diego123cruz/Z80Mini/README.md

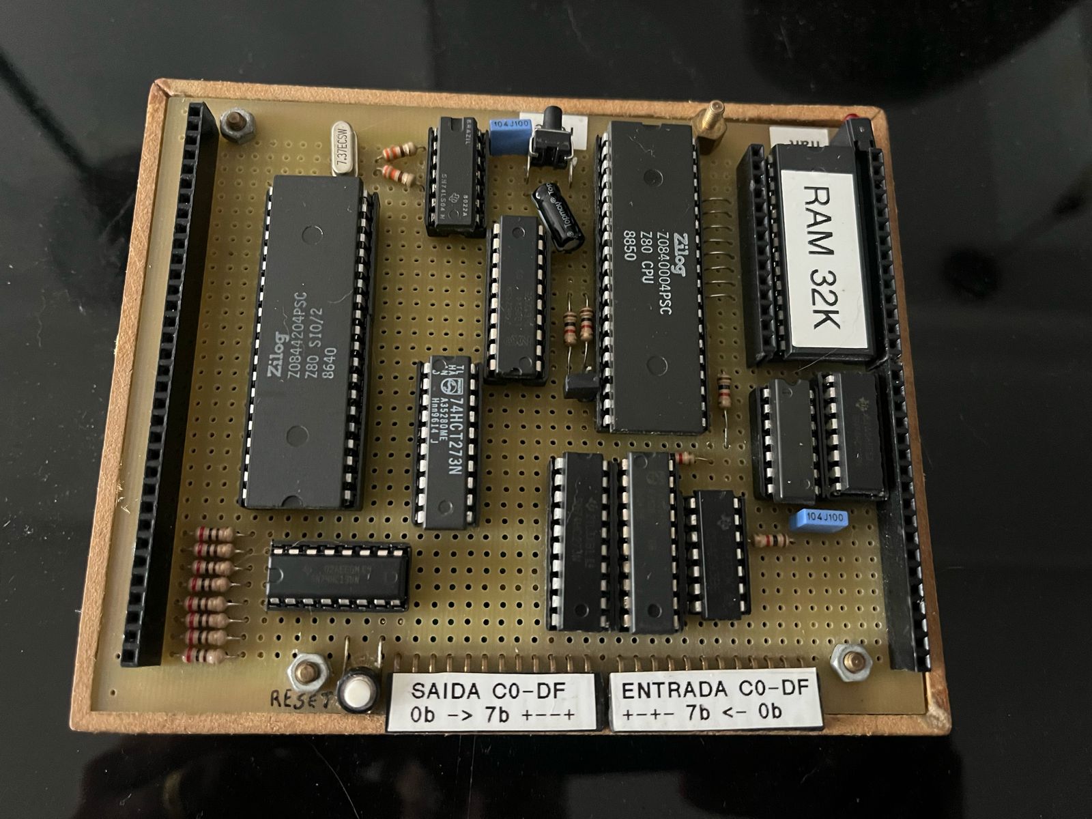
[picture p1: Z80Mini_BaseBoard.jpeg]
Z80Mini BaseBoard


# Z80Mini
Z80Mini foi pensado para ser um computador portátil e modular, temos uma placa base com o processador Z80 rodando em 7.372800Mhz, 32Kb de memória RAM, um soquete para a memória ROM, (que pode ser instalada na placa "Face"), duas portas de entradas e duas de saídas (a porta de saída 40h está ligada no barramento através de resistores de 200R).

## Spec
Z80 @7.372800Mhz

RAM 32kb @62256

ROM 32Kb @28C256

## Serial - SIO/2
SIOA_D $00 - MainBoard USB-Serial 115200 (FTDI)

SIOA_C $02 - MainBoard USB-Serial 115200 (FTDI)

SIOB_D $01 - Não usado

SIOB_C $03 - Não usado

## IN / OUT
OUT_40h with resistor 200R

IN_40h

OUT_C0h

IN_C0h

## Z80Mini - BaseBoard
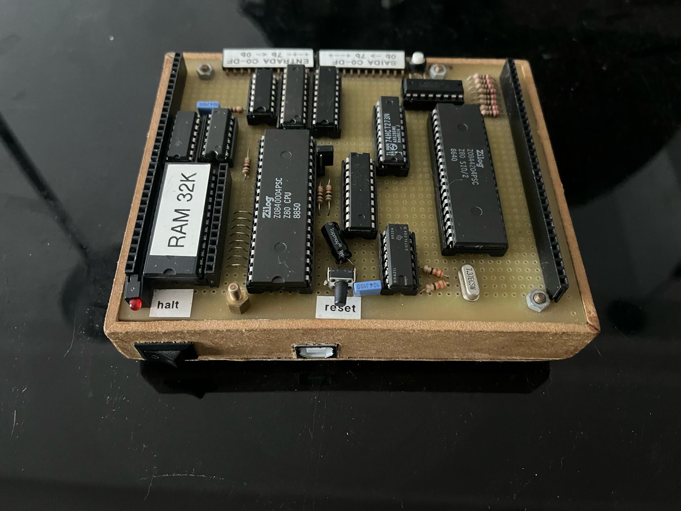
[picture p2: Z80Mini_BaseBoardPower.jpeg]
Z80Mini


[Schematic - All boards](https://github.com/diego123cruz/Z80Mini/blob/main/Schematic/Z80%20Mini%20-%20All%20boards.PDF)

## Faces
### Z80 Mem­ber­ship Card - Face
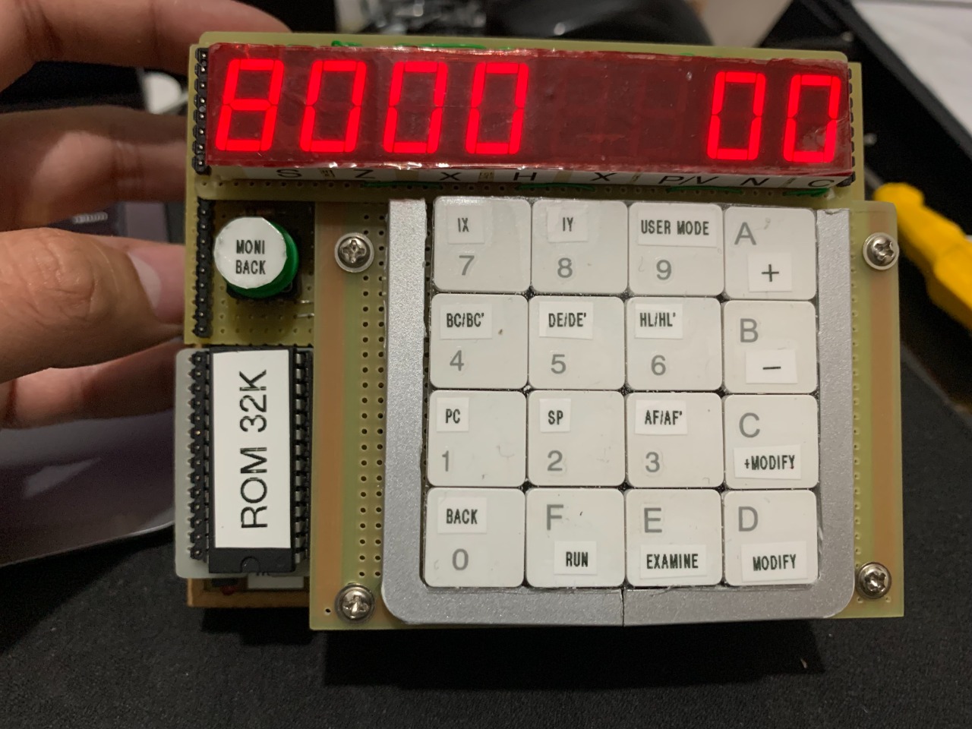
[picture p3: Z80 Mem­ber­ship Card - Face/Z80 Membership Card.jpeg]


[Vídeo](https://www.youtube.com/watch?v=1eWTQVRYLUw)

Essa placa "Face" foi baseada no "The Z80 Mem­ber­ship Card" - http://www.sunrise-ev.com/z80.htm

O circuito ou código-fonte podem conter partes do projeto original mencionado acima. Para mais detalhes sobre licenças copyright  consulte o autor do projeto original (http://www.sunrise-ev.com/z80.htm)

### Tec 1F (Southen Cross) - Face
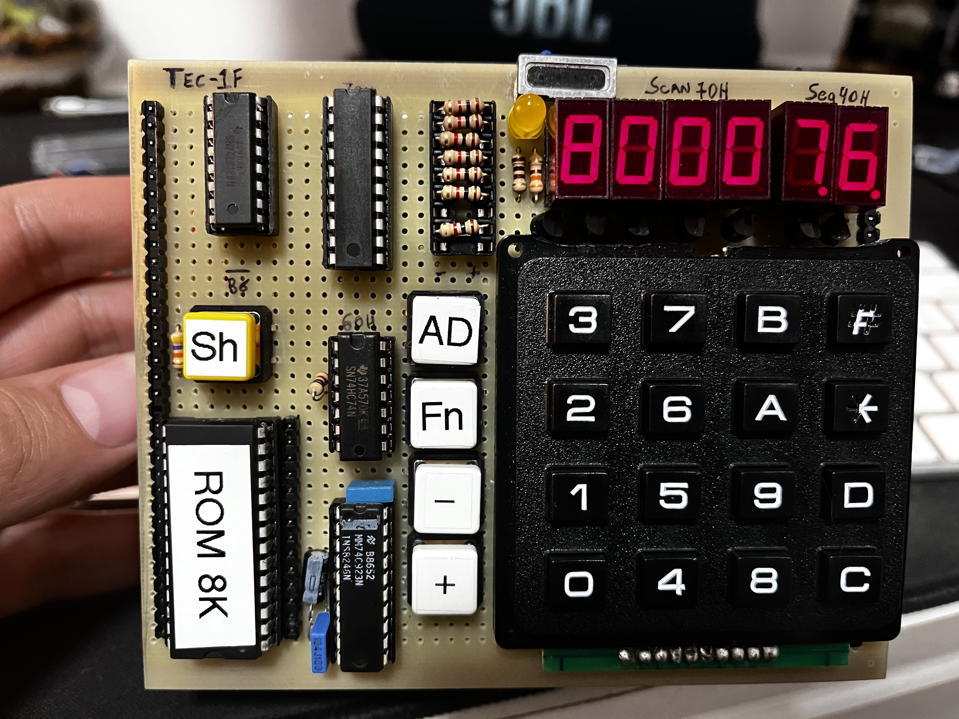
[picture p4: TEC-1(SC) - Face/Z80Mini-SouthernCross.jpeg]
Z80Mini


[Vídeo](https://www.youtube.com/watch?v=lcZihEMK4z4)

Essa placa "Face" foi baseada no "TEC 1 - Talking Electronics" (https://www.talkingelectronics.com/te_interactive_index.html) e tambem em algumas montagens:

Southern Cross Computer - https://github.com/crsjones/Southern-Cross-Computer-z80

The Big (Brian's) Monitor for the TEC-1F - https://github.com/bchiha/BMon

O circuito ou código-fonte podem conter partes dos projetos originais mencionado acima. Para mais detalhes sobre licenças copyright consulte os autores dos projetos originais.

### Basic LCD V1 - Face [DESCONTINUADO]
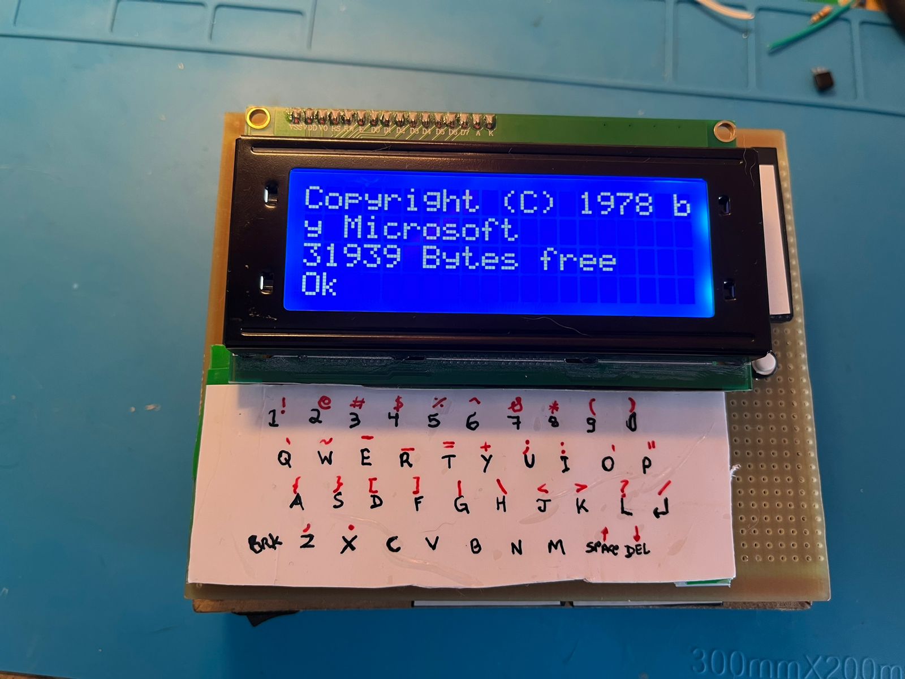
[picture p5: Basic LCD - Face [Descontinuado]/BasicLCD V1-Face.jpeg]


[Vídeo demo](https://www.youtube.com/watch?v=0nLOt6mwVDU)

[Vídeo detalhes](https://www.youtube.com/watch?v=qB5lAR5NyGU)

### Basic LCD Graphic 128x64 V2 - Face [DESCONTINUADO]
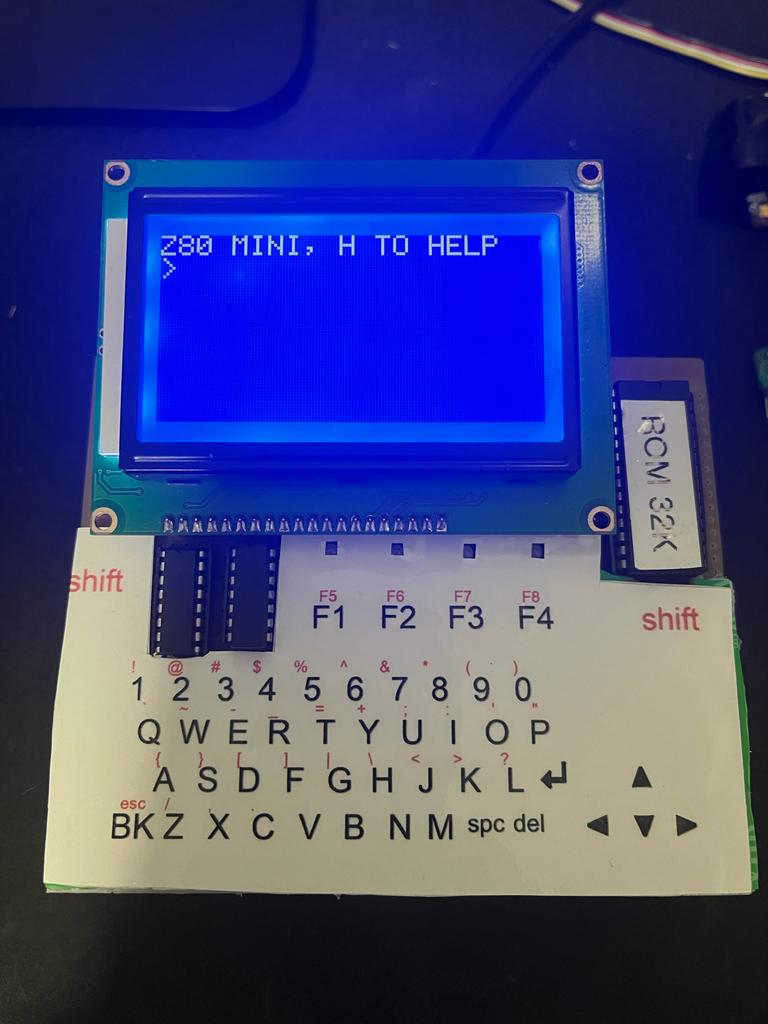
[picture p6: Basic LCD - Face [Descontinuado]/Basic LCD V2 (Graphic 128x64) - Face.jpg]


### Basic LCD Graphic 128x64 V3 - Face [NEW]
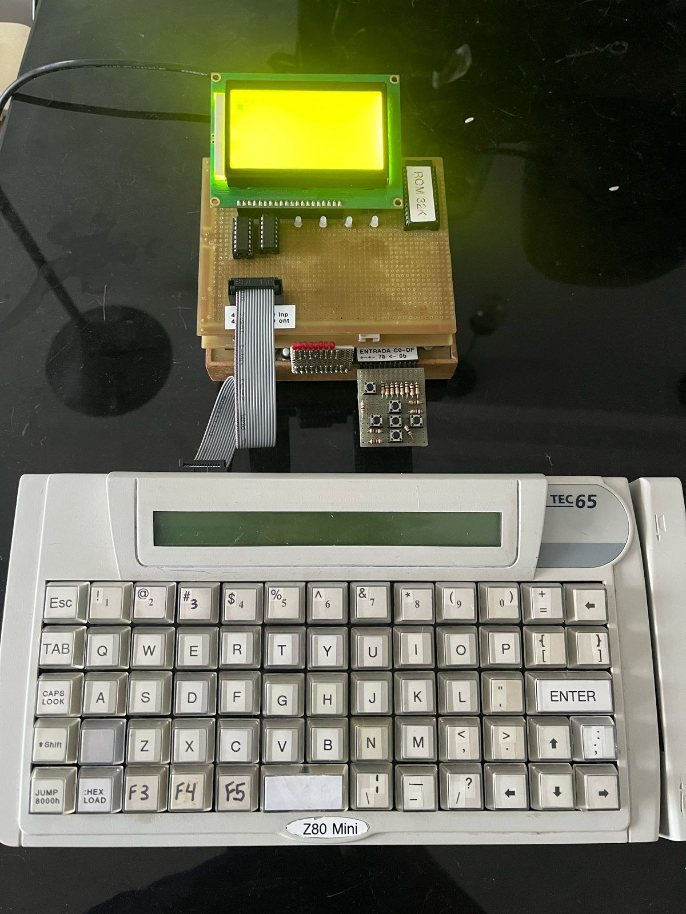
[picture p7: Z80MiniV3.jpeg]
Z80MiniV3


[Vídeo demo](https://www.youtube.com/shorts/OemEQMpTLIQ)

### GameCore - Face [NEW]
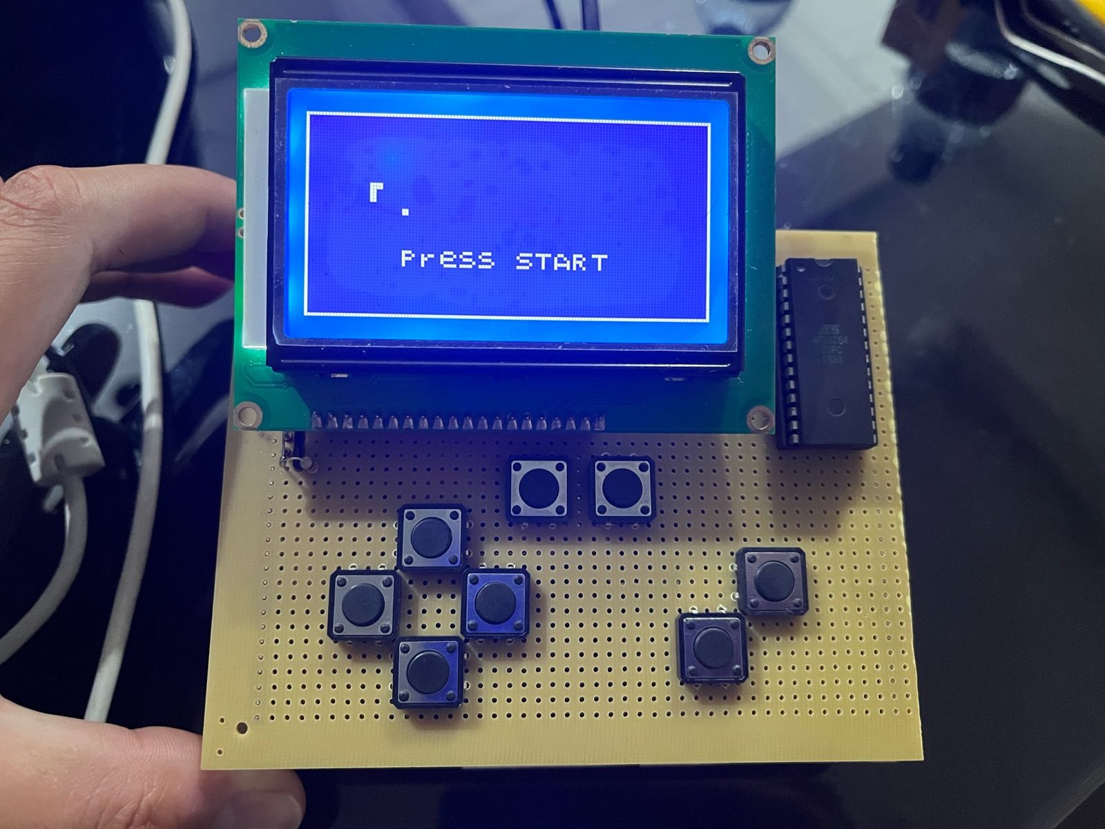
[picture p8: Z80Mini_GameCore_Face.jpeg]
Z80MiniGameCore


Essa placa "Face" foi baseada no "Grant's 7-chip Z80 computer" - http://searle.walesz80.htm e "Z80 SINGLE BOARD COMPUTER" - http://d-fence.sytes.net/z80sbc/

O circuito ou código-fonte podem conter partes do projeto original mencionado acima. Para mais detalhes sobre licenças copyright consulte os autores dos projetos originais.

### Mais vídeos
[Meu canal](https://www.youtube.com/@diego123cruz/videos)
