diego123cruz/Z80Mini/Graphics Display + Keyboard 65 - Face/README.md

Z80Mini Graphics LCD v3 Z80Mini BaseBoard

### Graphics Display (128x64) + Keyboard TEC 65 - Face

Essa placa "Face" foi baseada no "Grant's 7-chip Z80 computer" - http://searle.walesz80.htm e "Z80 SINGLE BOARD COMPUTER" - http://d-fence.sytes.net/z80sbc/

O circuito ou código-fonte podem conter partes do projeto original mencionado acima. Para mais detalhes sobre licenças copyright consulte os autores dos projetos originais.
