diego123cruz/Z80Mini/TEC-1(SC) - Face/ReferenceFiles/Docs/MemoryDevices01.pdf

# 28 Pin EPROM, EEPROM and RAM Pinouts

### Note:

1. CE,OE,WE are Active low inputs.
2. In general NC pins should be left unconnected. Consult the manufacturer’s data for specific information.
3. VPP and PGM pins should be connected to VCC when not used in programming, except for the 2732 dual function pin 20, OE/VPP.
4. Connect the WE of EEPROM devices to VCC to inhibit unintentional write cycles.

Craig Jones 09/21 V1

SRAM | EEPROM | EPROM | SRAM | EEPROM | EPROM | EPROM | SRAM | EEPROM | EPROM | EPROM | EEPROM | SRAM | EPROM | EPROM | EEPROM | SRAM | EPROM | EEPROM | SRAM
62256 | 28C256 | 27256 | 6264 | 28C64 | 2764 | 2732 | 6116 | 28C16 | 2716 | 2716 | 28C16 | 6116 | 2732 | 2764 | 28C64 | 6264 | 27256 | 28C256 | 62256
A14 | A14 | VPP | NC | NC | VPP | | | | | | | | | VCC | VCC | VCC | VCC | VCC | VCC
A12 | A12 | A12 | A12 | A12 | A12 | | | | | | | | | PGM | WE | WE | A14 | WE | WE
A7 | A7 | A7 | A7 | A7 | A7 | A7 | A7 | A7 | A7 | VCC | VCC | VCC | VCC | NC | NC | CS2 | A13 | A13 | A13
A6 | A6 | A6 | A6 | A6 | A6 | A6 | A6 | A6 | A6 | A8 | A8 | A8 | A8 | A8 | A8 | A8 | A8 | A8 | A8
A5 | A5 | A5 | A5 | A5 | A5 | A5 | A5 | A5 | A5 | A9 | A9 | A9 | A9 | A9 | A9 | A9 | A9 | A9 | A9
A4 | A4 | A4 | A4 | A4 | A4 | A4 | A4 | A4 | A4 | VPP | WE | WE | A11 | A11 | A11 | A11 | A11 | A11 | A11
A3 | A3 | A3 | A3 | A3 | A3 | A3 | A3 | A3 | A3 | OE | OE | OE | OE/VPP | OE | OE | OE | OE | OE | OE
A2 | A2 | A2 | A2 | A2 | A2 | A2 | A2 | A2 | A2 | A10 | A10 | A10 | A10 | A10 | A10 | A10 | A10 | A10 | A10
A1 | A1 | A1 | A1 | A1 | A1 | A1 | A1 | A1 | A1 | CE | CE | CE | CE | CE | CE | CE | CE | CE | CE
A0 | A0 | A0 | A0 | A0 | A0 | A0 | A0 | A0 | A0 | D7 | D7 | D7 | D7 | D7 | D7 | D7 | D7 | D7 | D7
D0 | D0 | D0 | D0 | D0 | D0 | D0 | D0 | D0 | D0 | D6 | D6 | D6 | D6 | D6 | D6 | D6 | D6 | D6 | D6
D1 | D1 | D1 | D1 | D1 | D1 | D1 | D1 | D1 | D1 | D5 | D5 | D5 | D5 | D5 | D5 | D5 | D5 | D5 | D5
D2 | D2 | D2 | D2 | D2 | D2 | D2 | D2 | D2 | D2 | D4 | D4 | D4 | D4 | D4 | D4 | D4 | D4 | D4 | D4
GND | GND | GND | GND | GND | GND | GND | GND | GND | GND | D3 | D3 | D3 | D3 | D3 | D3 | D3 | D3 | D3 | D3
