diego123cruz/Z80Mini/Z80 Membership Card  - Face/README.md

Z80 Mem­ber­ship Card - Face

### Z80 Mem­ber­ship Card - Face
Essa placa "Face" foi baseada no "The Z80 Mem­ber­ship Card" - http://www.sunrise-ev.com/z80.htm

O circuito ou código-fonte podem conter partes do projeto original mencionado acima. Para mais detalhes sobre licenças copyright  consulte o autor do projeto original (http://www.sunrise-ev.com/z80.htm)

[Vídeo](https://www.youtube.com/watch?v=1eWTQVRYLUw)

#### Base board

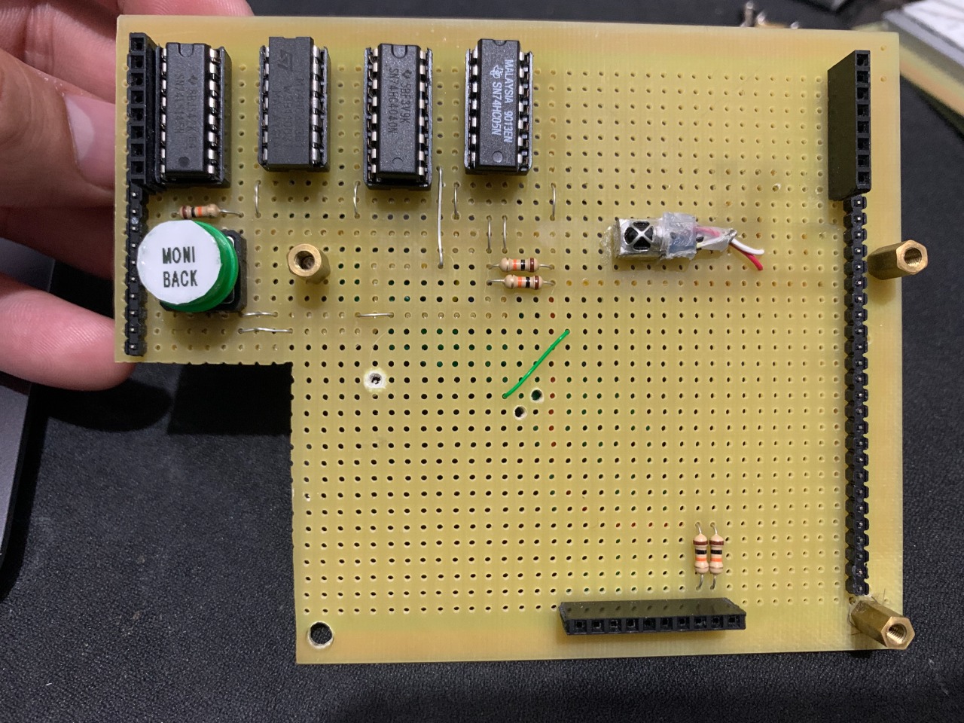
[picture p9: Z80 Membership Card - Face/Base.jpeg]
Base


#### Keyboard

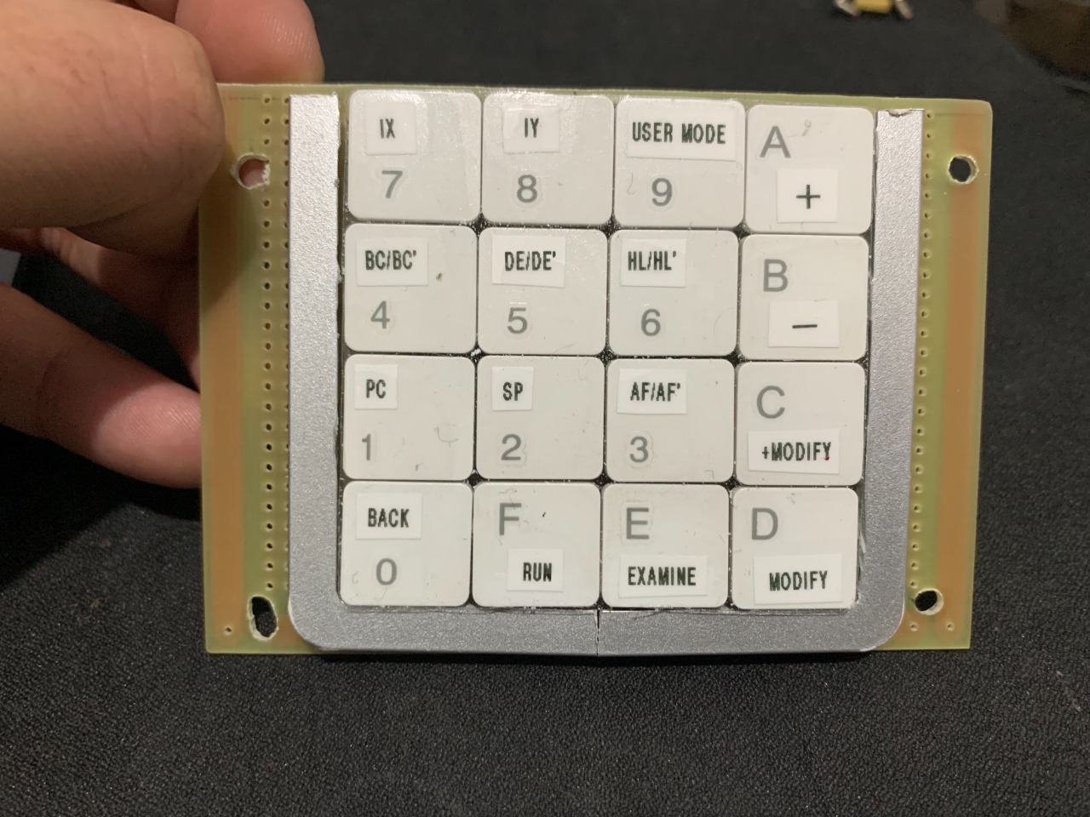
[picture p10: Z80 Membership Card - Face/Keyboard.jpeg]
keys


#### 7Seg display

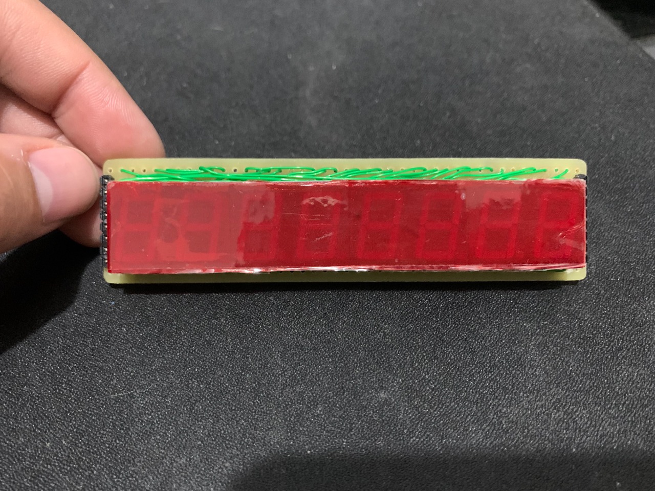
[picture p11: Z80 Membership Card - Face/7SegDisplay.jpeg]
7Segs display
