diego123cruz/Z80Mini/Basic LCD - Face [Descontinuado]/README.md

Z80Mini LCD v1 Z80Mini BaseBoard

### Basic LCD V1 - Face

[Vídeo demo](https://www.youtube.com/watch?v=0nLOt6mwVDU)

[Vídeo detalhes](https://www.youtube.com/watch?v=qB5lAR5NyGU)

Z80Mini BaseBoard Z80Mini LCD v2 128x64

### Basic LCD V2 (Graphic 128x64) - Face

Essa placa "Face" foi baseada no "Grant's 7-chip Z80 computer" - http://searle.walesz80.htm e "Z80 SINGLE BOARD COMPUTER" - http://d-fence.sytes.net/z80sbc/

O circuito ou código-fonte podem conter partes do projeto original mencionado acima. Para mais detalhes sobre licenças copyright consulte os autores dos projetos originais.

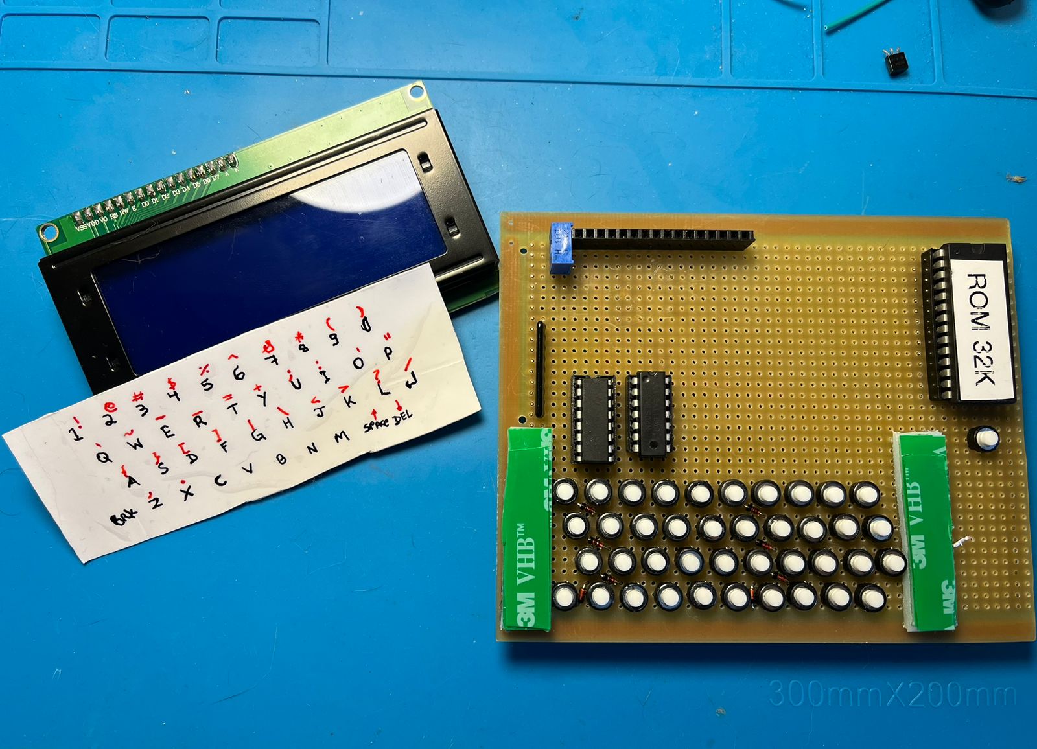
[picture p12: Basic LCD - Face [Descontinuado]/BasicLCDParts-Face.jpeg]
Z80Mini
