diego123cruz/Z80Mini/BIOS/Programas/Display lcd 40x2 IIC/example.jpeg

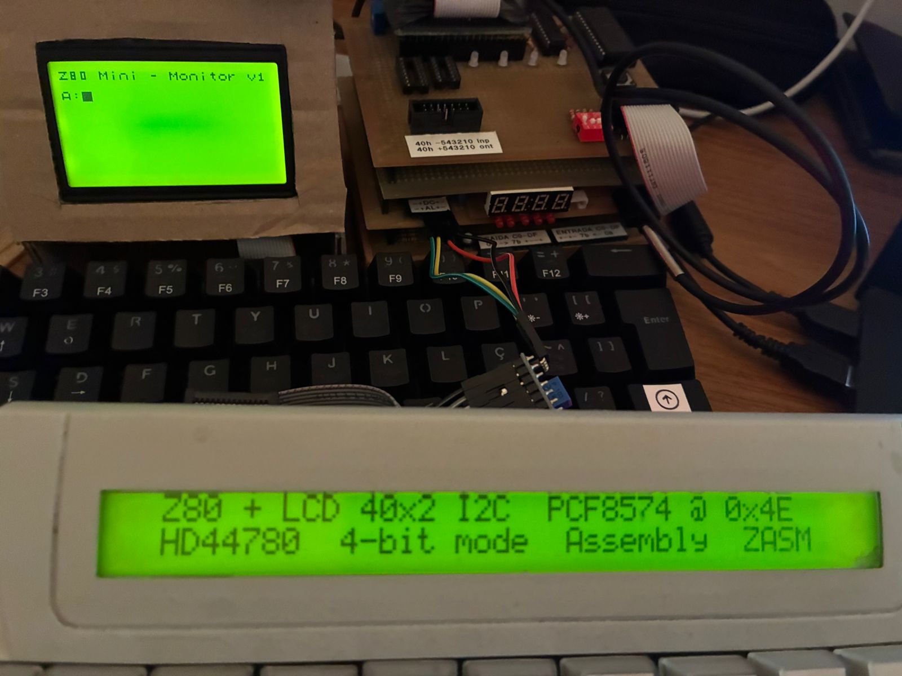
BIOS/Programas/Display lcd 40x2 IIC/example.jpeg
