diego123cruz/Z80Mini/BIOS/Programas/Display oled ssd1306_128x32/example.jpeg

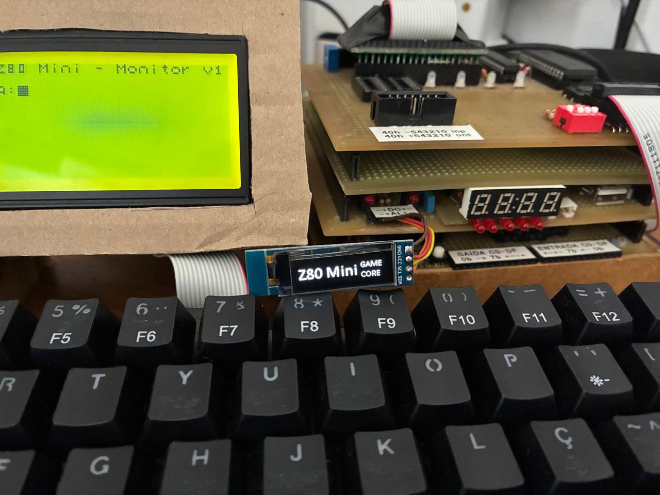
BIOS/Programas/Display oled ssd1306_128x32/example.jpeg
