diego123cruz/Z80Mini/BIOS/Programas/Display oled ssd1306_128x32/image/LLCDAssistant - example.JPG

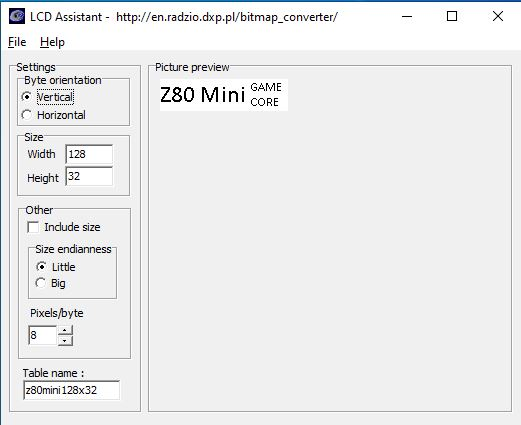
BIOS/Programas/Display oled ssd1306_128x32/image/LLCDAssistant - example.JPG
