diego123cruz/Z80Mini/BIOS/Programas/Games/AirplaneBomb/example.jpeg

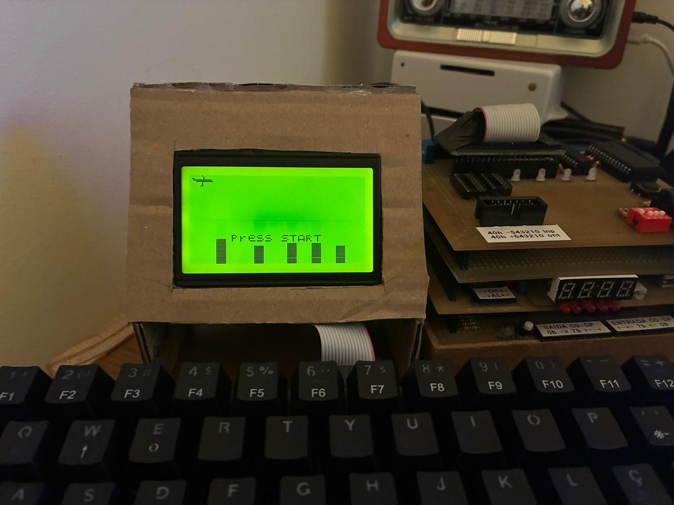
BIOS/Programas/Games/AirplaneBomb/example.jpeg
