diego123cruz/Z80Mini/BIOS/Programas/Games/Snake/example.jpeg

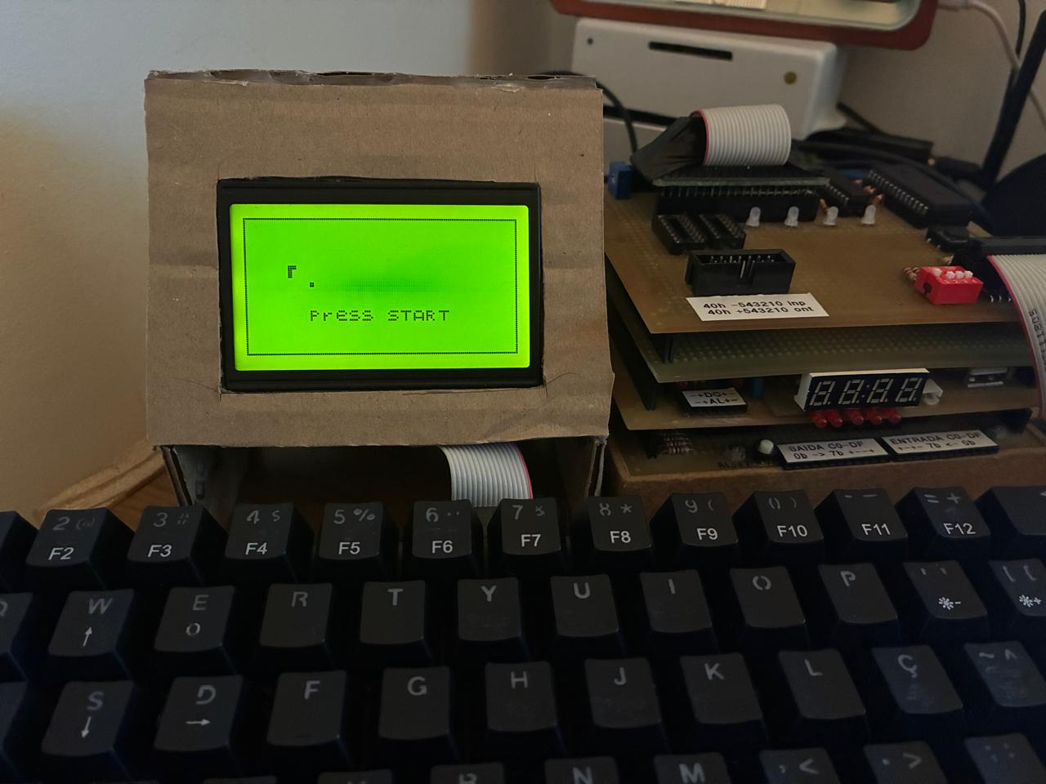
BIOS/Programas/Games/Snake/example.jpeg
