diego123cruz/Z80Mini/BIOS/Programas/Games/TankRun/example.jpeg

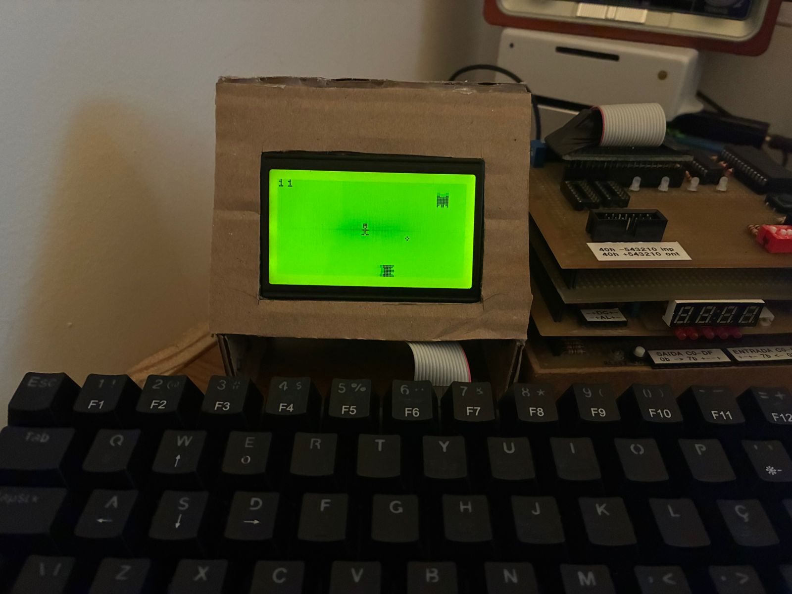
BIOS/Programas/Games/TankRun/example.jpeg
