diego123cruz/Z80Mini/BIOS/Programas/Games/TicTacToe/example.jpeg

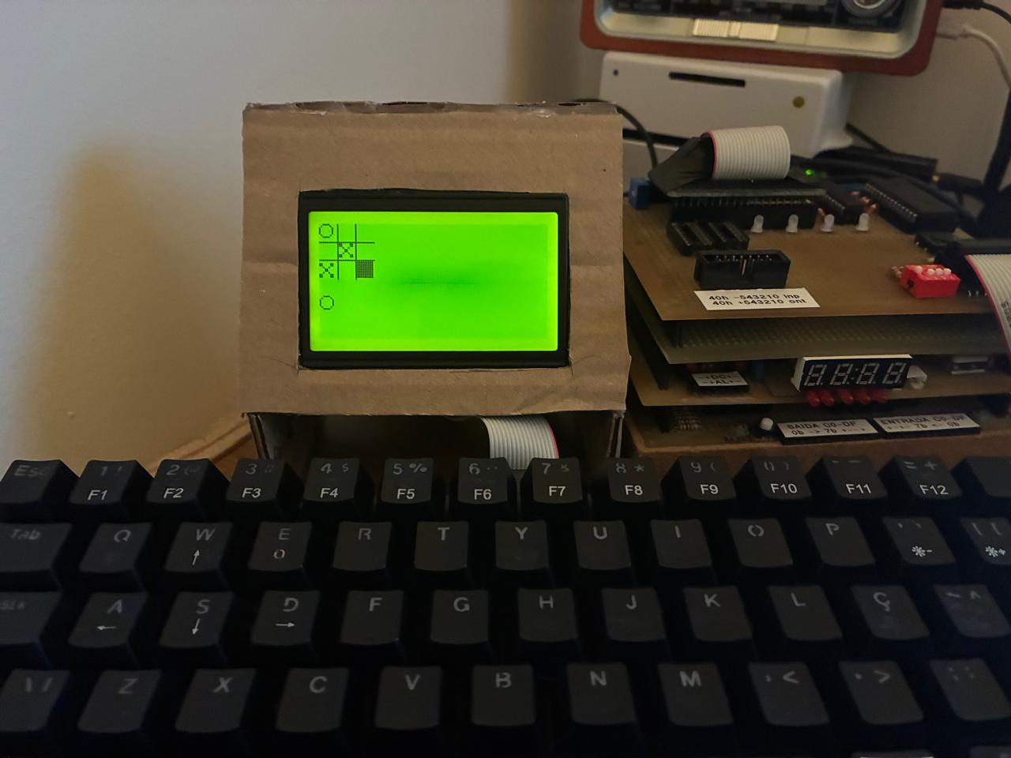
BIOS/Programas/Games/TicTacToe/example.jpeg
