diego123cruz/Z80Mini/BIOS/Programas/Relogio/example.jpeg

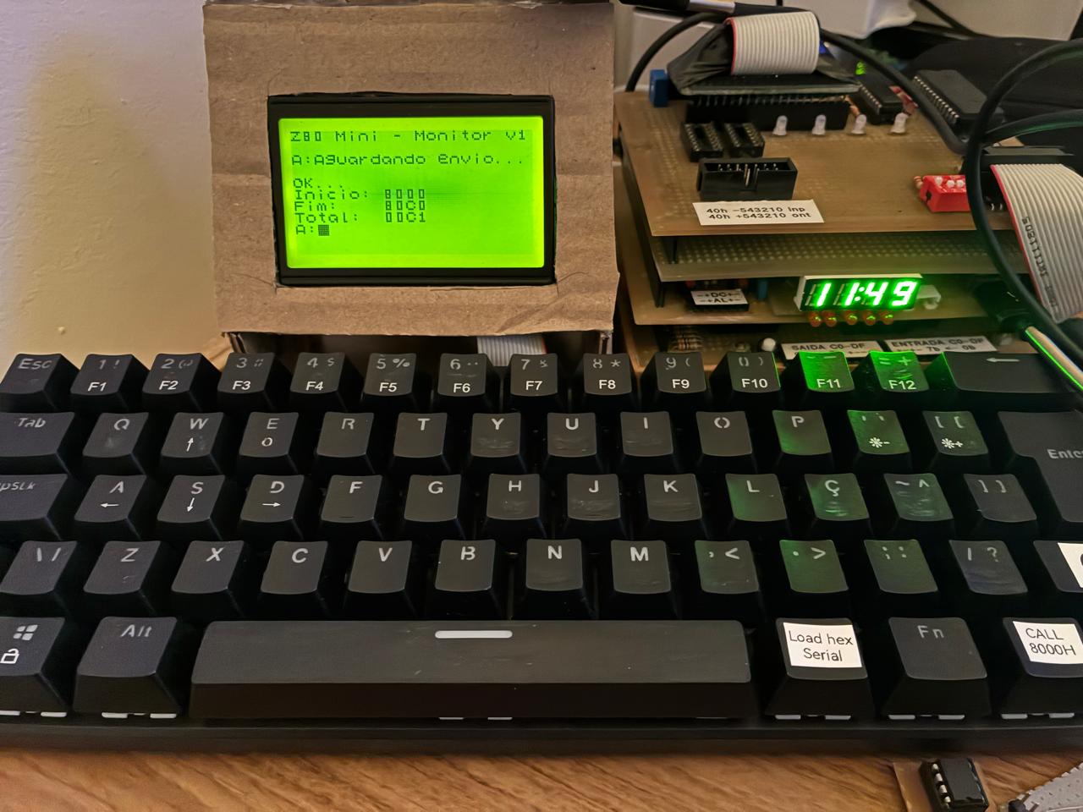
BIOS/Programas/Relogio/example.jpeg
