diego123cruz/Z80Mini/BIOS/Programas/SSD1306_SSD1106_I2C_128x64/SSD1306.jpeg

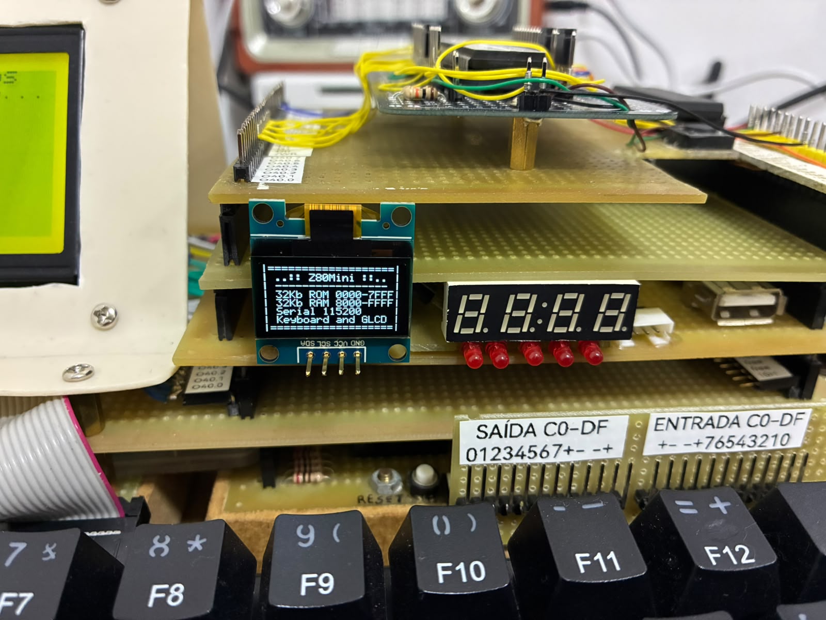
BIOS/Programas/SSD1306_SSD1106_I2C_128x64/SSD1306.jpeg
