diego123cruz/Z80Mini/BIOS/Programas/Term v0.1/example.jpeg

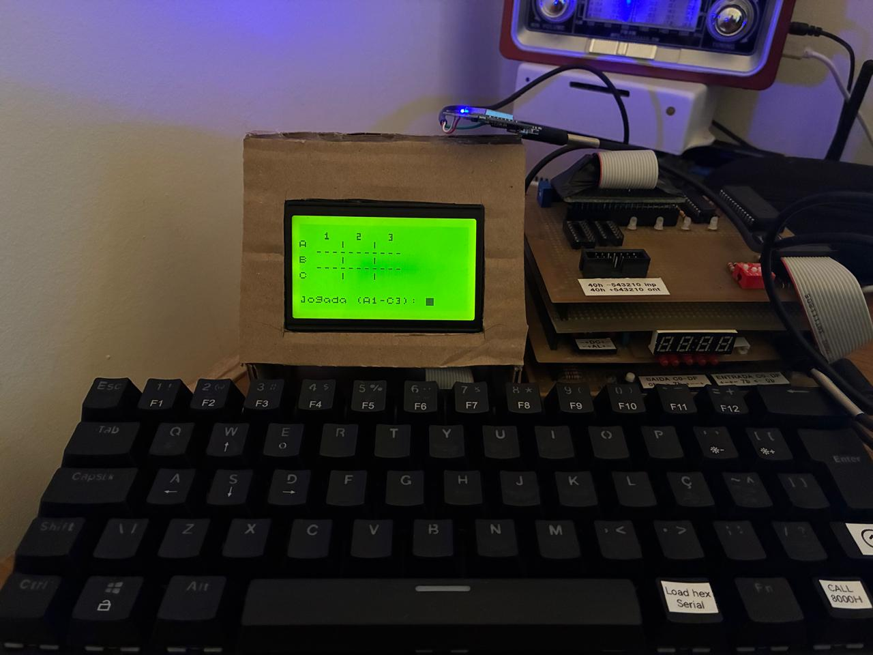
BIOS/Programas/Term v0.1/example.jpeg
