diego123cruz/Z80Mini/BIOS/sdcc /demo/example.jpeg

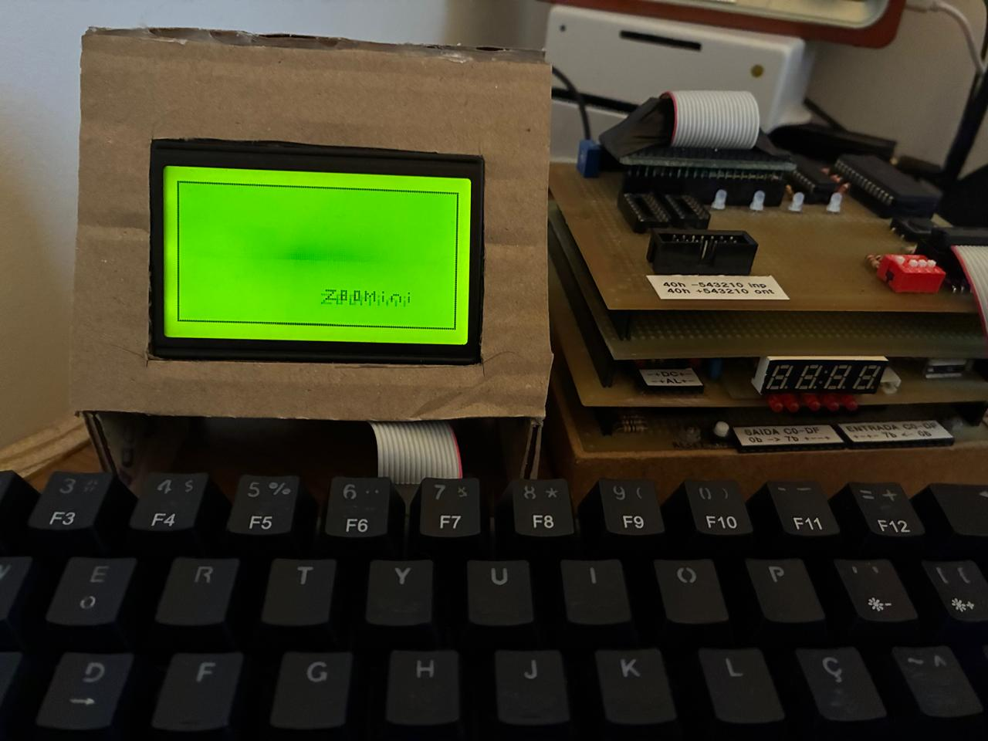
BIOS/sdcc /demo/example.jpeg
