diego123cruz/Z80Mini/BIOS/sdcc /filter/example.jpeg

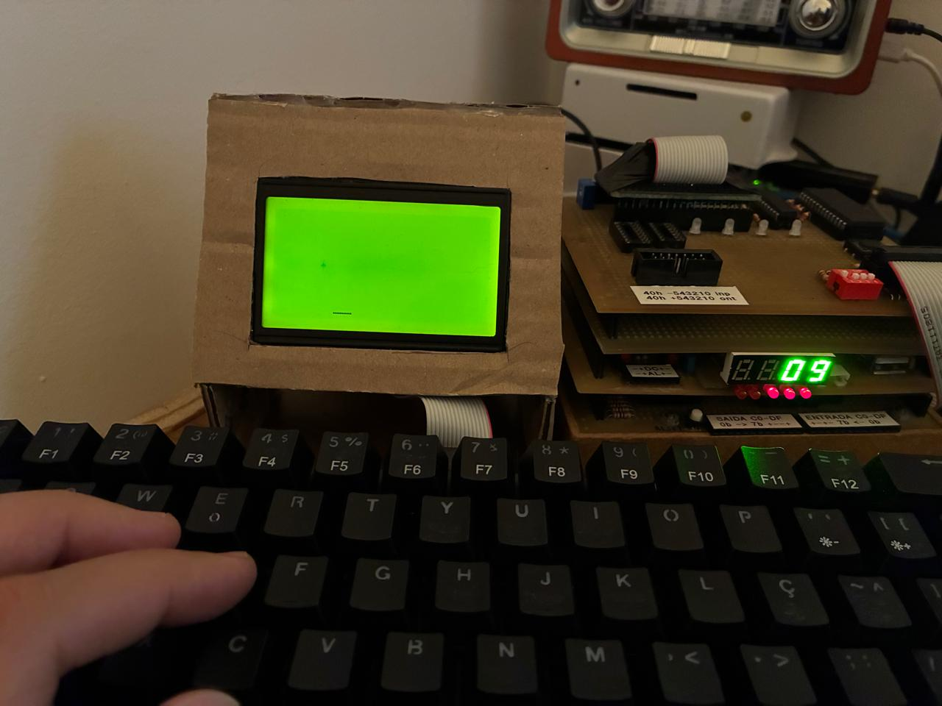
BIOS/sdcc /filter/example.jpeg
