diego123cruz/Z80Mini/External Feature/ArduBox_I2C/ArduBoxIIC.jpeg

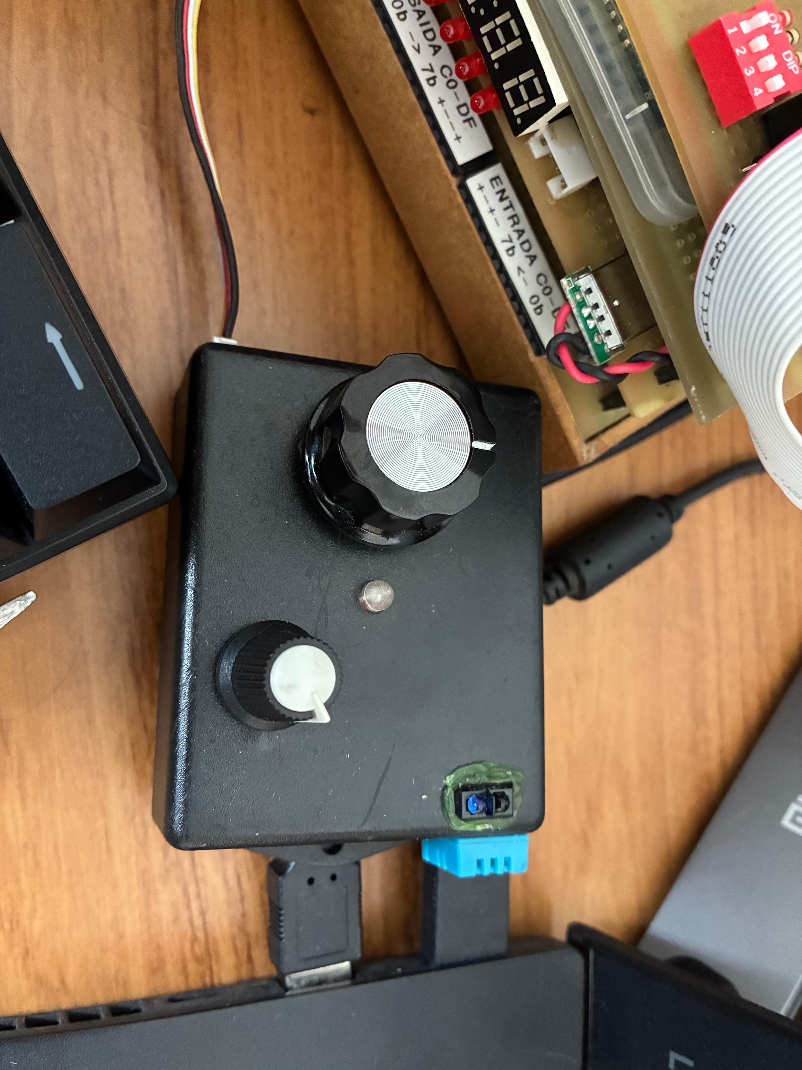
External Feature/ArduBox_I2C/ArduBoxIIC.jpeg
