diego123cruz/Z80Mini/External Feature/ArduBox_I2C/Circuit.jpeg

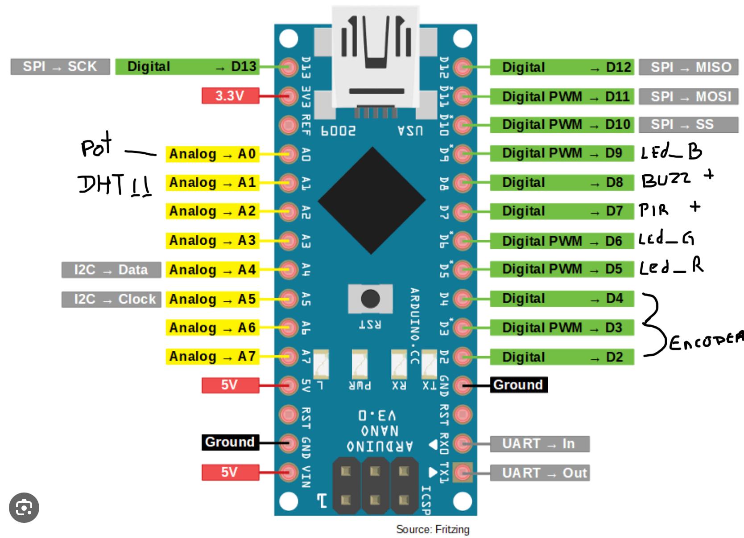
External Feature/ArduBox_I2C/Circuit.jpeg
