diego123cruz/Z80Mini/External Feature/ArduBox_I2C/Commands.jpeg

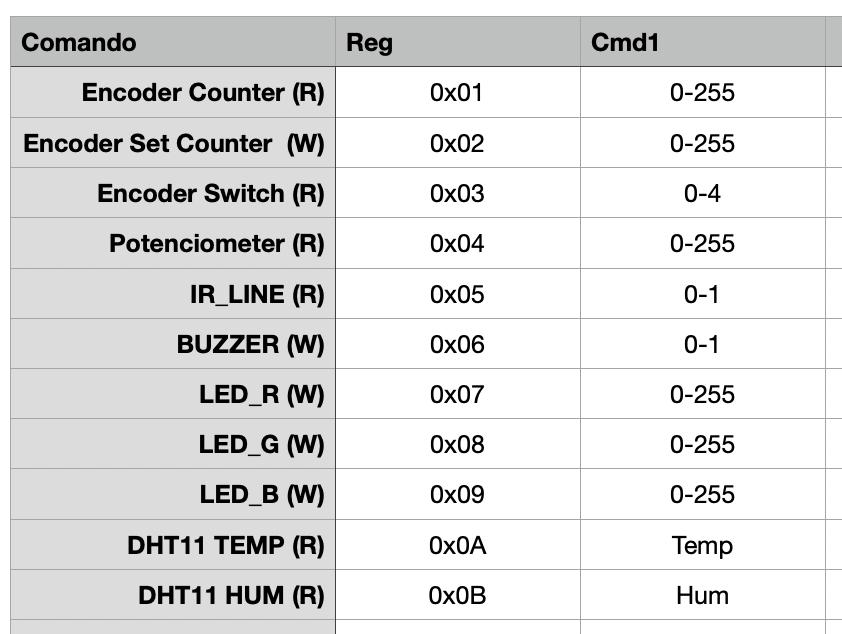
External Feature/ArduBox_I2C/Commands.jpeg
