diego123cruz/Z80Mini/External Feature/Display7segSom/ArduinoBoard.jpg

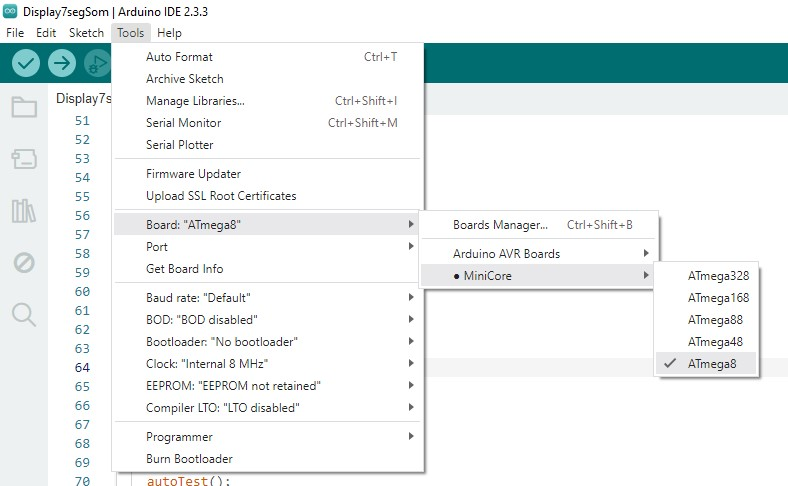
External Feature/Display7segSom/ArduinoBoard.jpg
