diego123cruz/Z80Mini/External Feature/Display7segSom/Atmega8_OscInt8Mhz.JPG

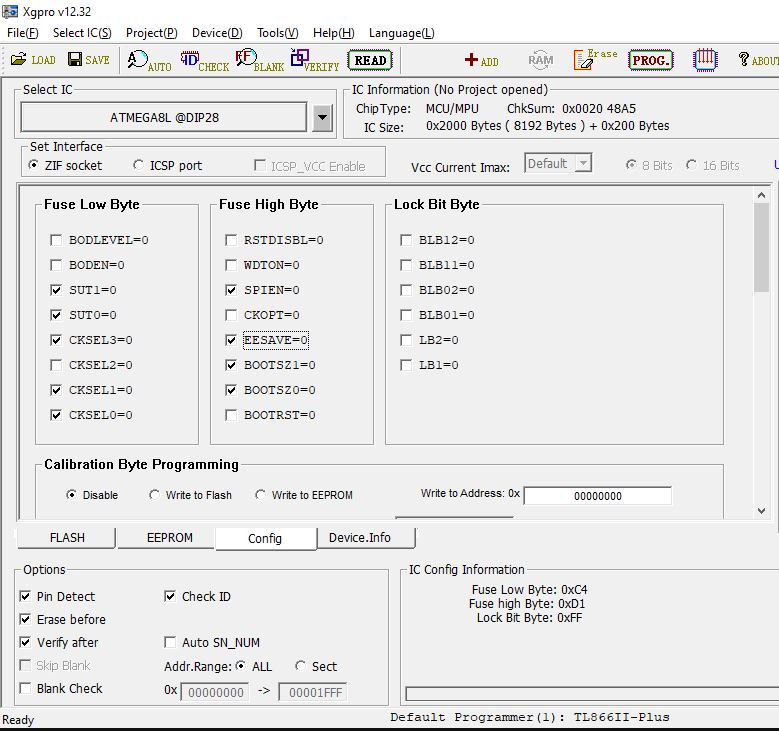
External Feature/Display7segSom/Atmega8_OscInt8Mhz.JPG
