diego123cruz/Z80Mini/External Feature/Display7segSom/atmega8_pinout.jpg

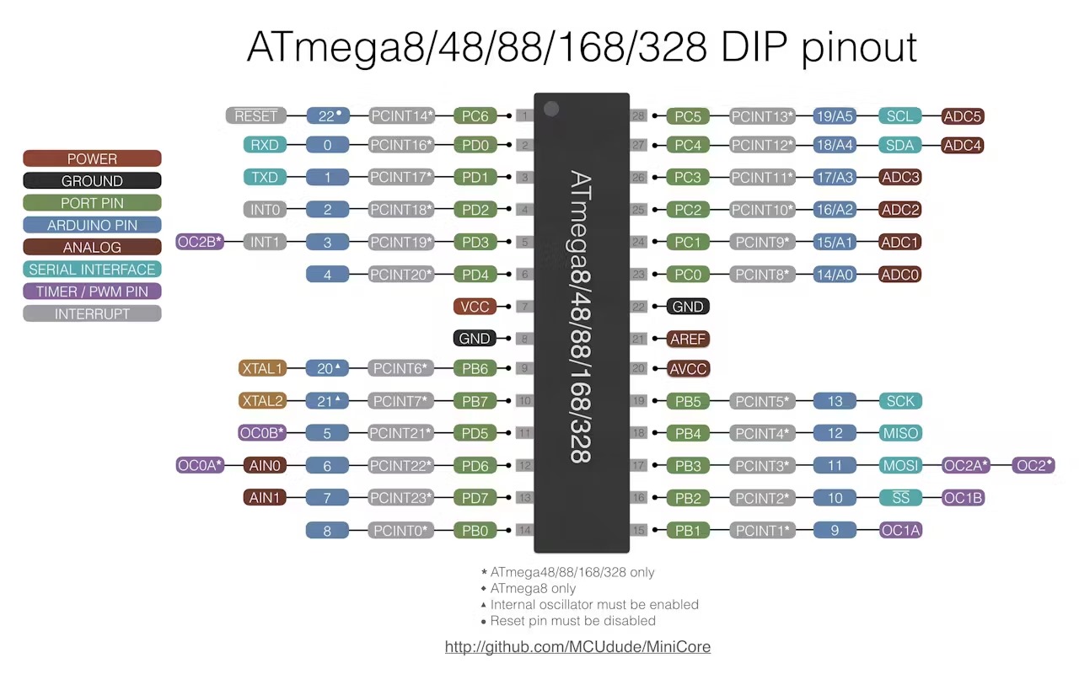
External Feature/Display7segSom/atmega8_pinout.jpg
