diego123cruz/Z80Mini/External Feature/Display7segSom/img1.jpg

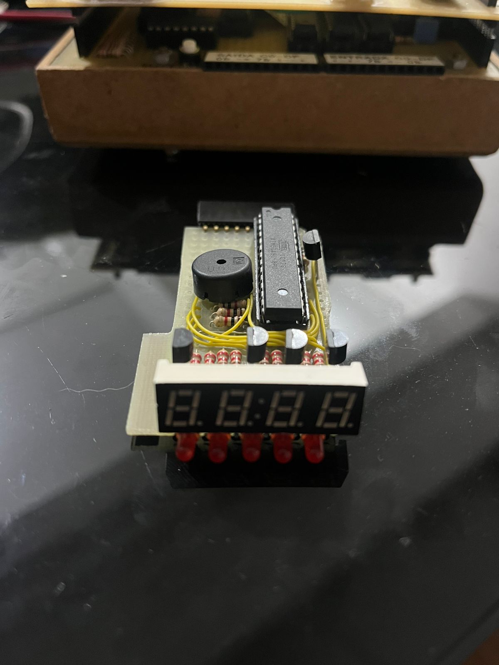
External Feature/Display7segSom/img1.jpg
