diego123cruz/Z80Mini/External Feature/Display7segSom/img2.jpg

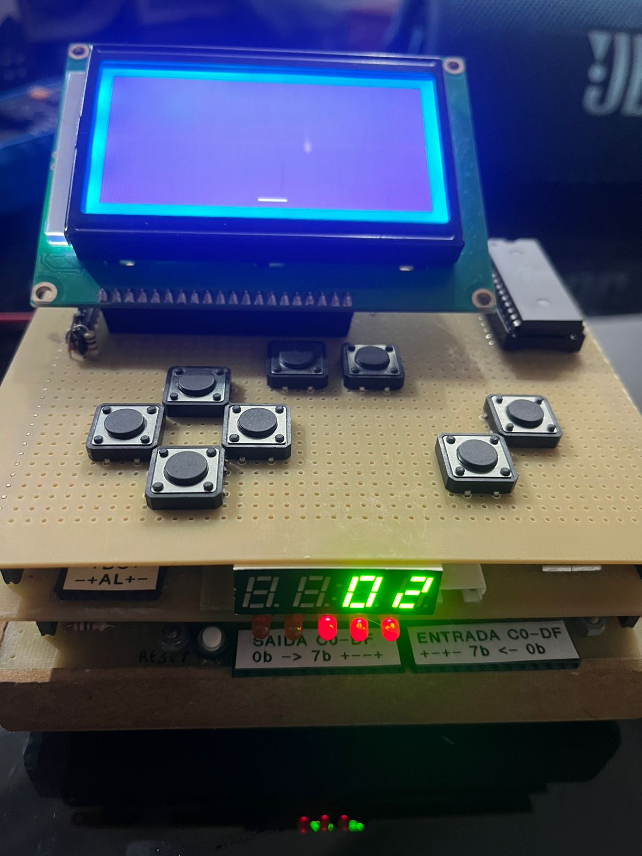
External Feature/Display7segSom/img2.jpg
