diego123cruz/Z80Mini/External Feature/Display7segSom/img.jpg

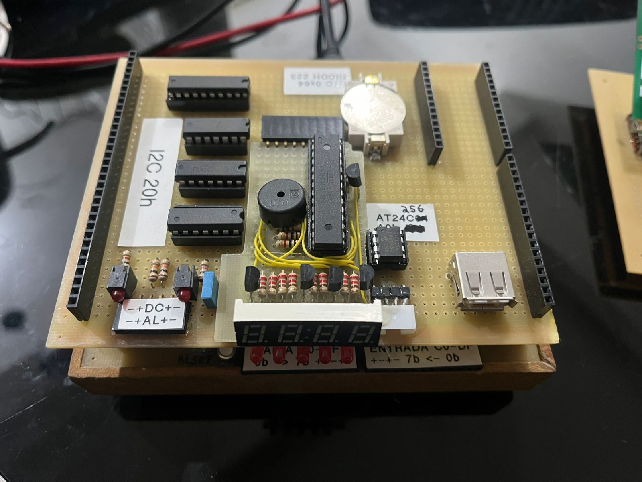
External Feature/Display7segSom/img.jpg
