diego123cruz/Z80Mini/Graphics Display + Keyboard 65 - Face/Z80Mini-C/SDCC Calling Convertion V1.jpg

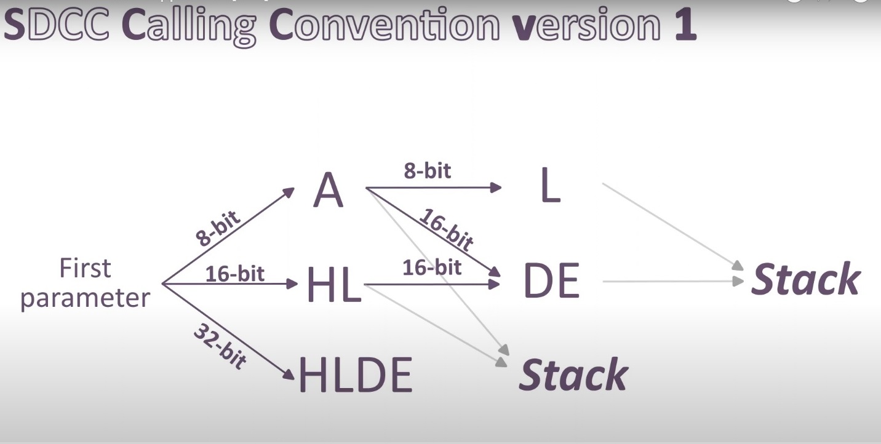
Graphics Display + Keyboard 65 - Face/Z80Mini-C/SDCC Calling Convertion V1.jpg
