diego123cruz/Z80Mini/photos/main.jpg

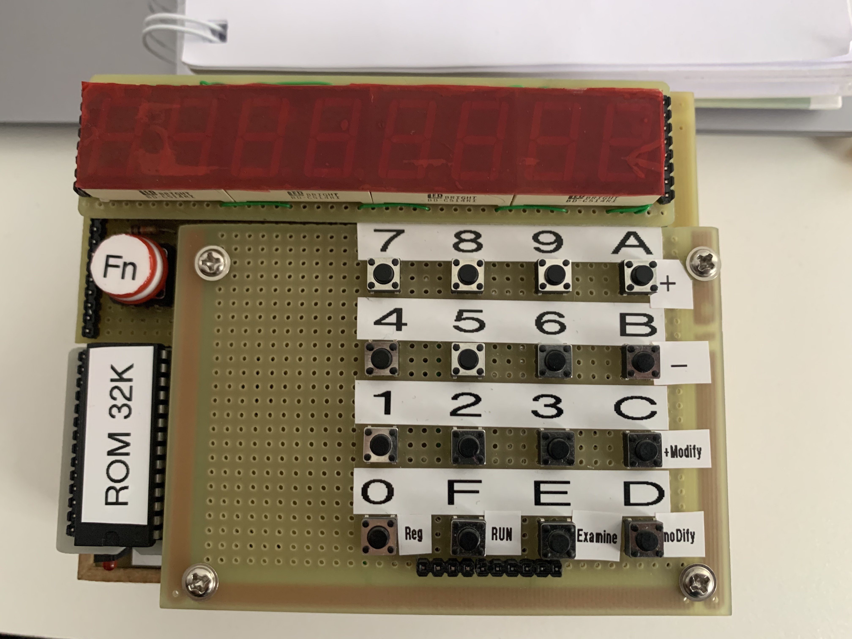
photos/main.jpg
