diego123cruz/Z80Mini/Z80Mini_Module_I2C.jpeg

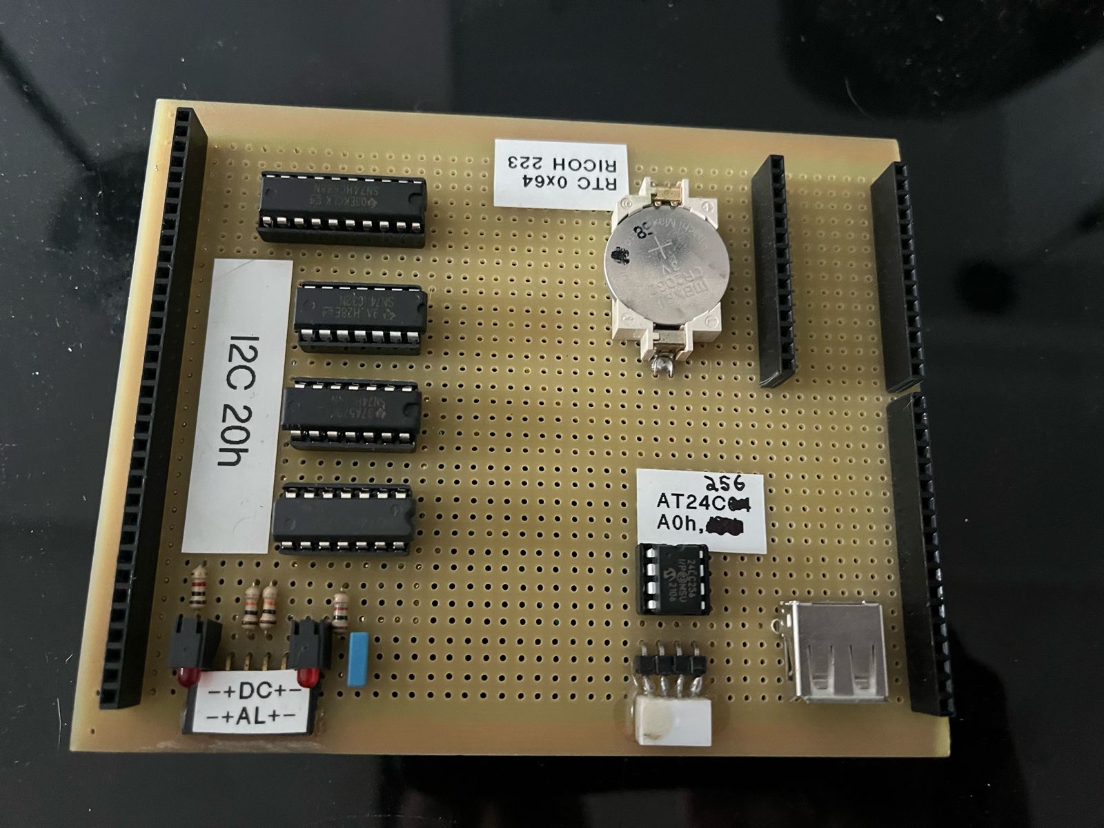
Z80Mini_Module_I2C.jpeg
