diego123cruz/Z80Mini/TEC-1(SC) - Face/ReferenceFiles/SC-8x8_LED_Matrix/SC-8x8_R4/Link.stl

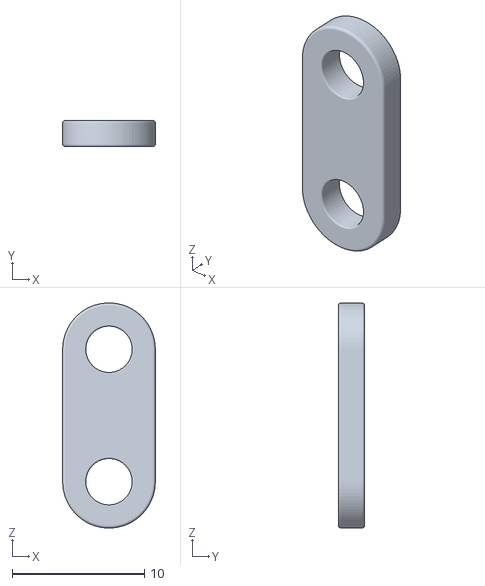
[picture p39: CAD file, 2022-09-05]
TEC-1(SC) - Face/ReferenceFiles/SC-8x8_LED_Matrix/SC-8x8_R4/Link.stl
7.00 x 2.00 x 17.0
