diego123cruz/Z80Mini/External Feature/Printer - MTP-II/img1.jpg

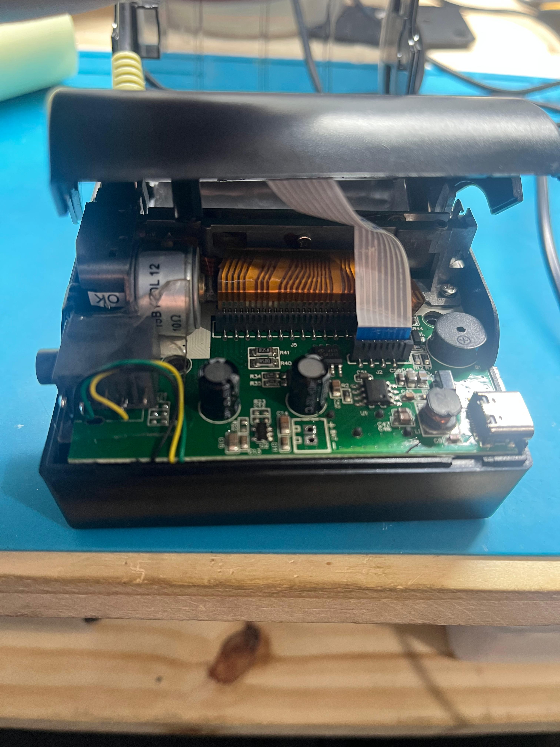
External Feature/Printer - MTP-II/img1.jpg
