diego123cruz/Z80Mini/External Feature/Printer - MTP-II/img2.jpg

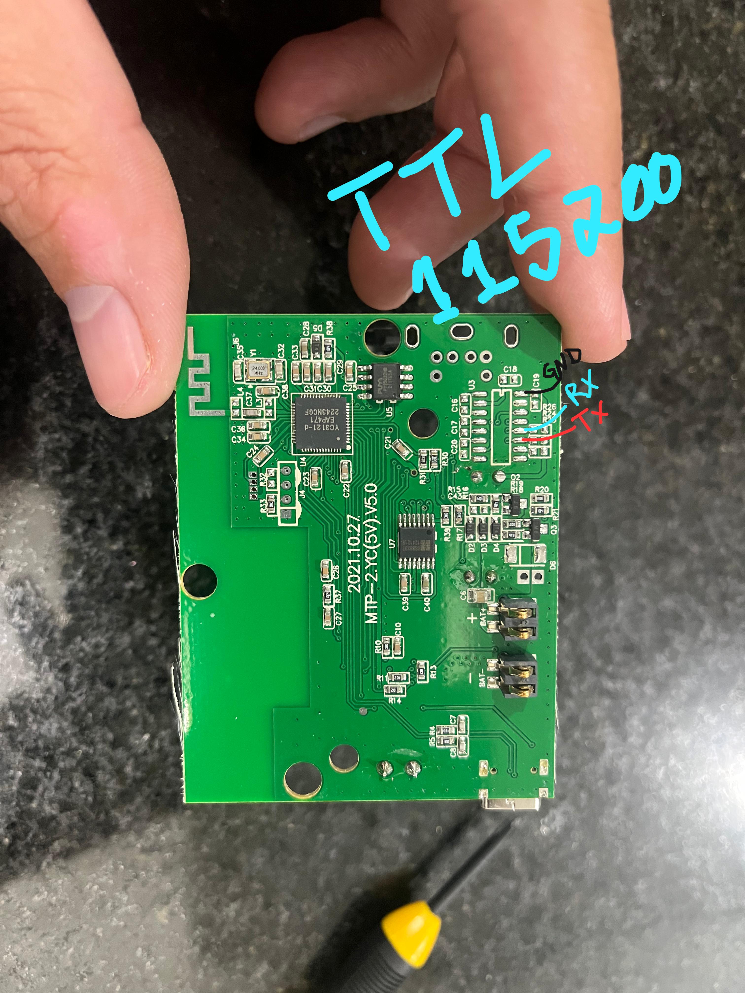
External Feature/Printer - MTP-II/img2.jpg
