diego123cruz/Z80Mini/External Feature/Printer - MTP-II/img3.jpg

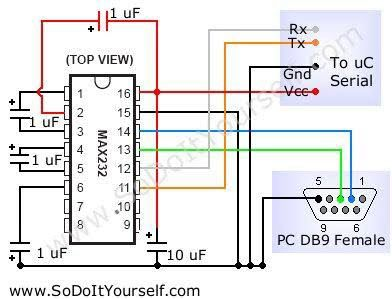
External Feature/Printer - MTP-II/img3.jpg
