diego123cruz/Z80Mini/External Feature/Printer - MTP-II/img4.jpg

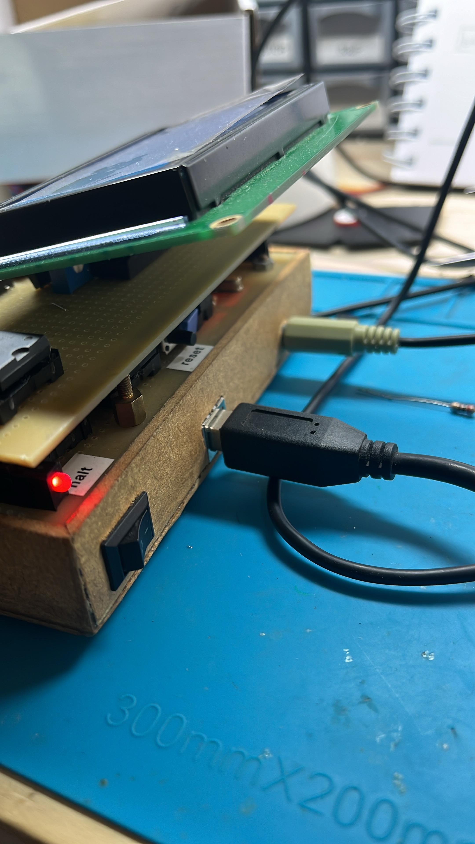
External Feature/Printer - MTP-II/img4.jpg
