diego123cruz/Z80Mini/External Feature/Printer - MTP-II/img5.jpg

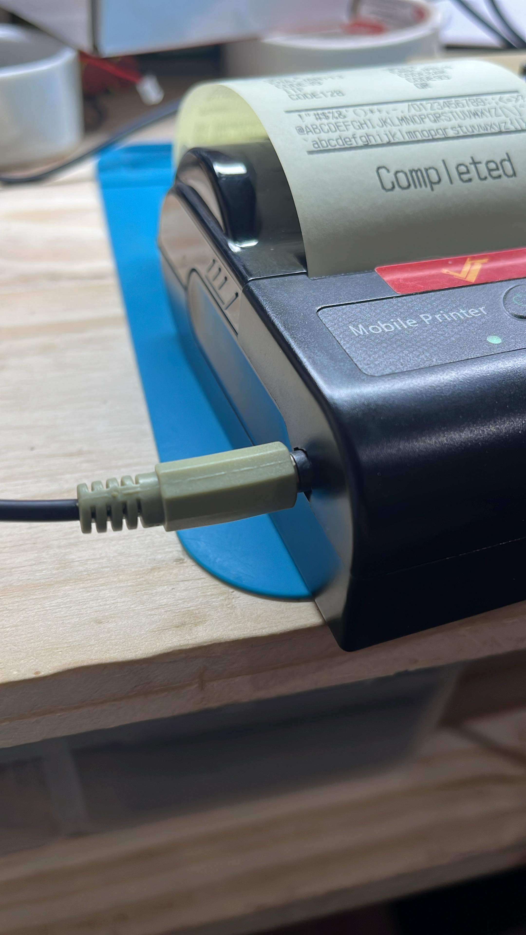
External Feature/Printer - MTP-II/img5.jpg
