diego123cruz/Z80Mini/Basic LCD - Face/Program/LCDGraphic/Testes Imagens/JavaScript /index.html

# Z80 Mini - Convert intelHex to Bin file (Protocol)

#### 'D' + [name, max 16] + [type] + [size, 2 bytes] + [file code, n...] + 'O'

##### Types: 0x00 - Execute, 0x01 - Image, 0x02 - Text

Nome: (Max 16 caracteres)

Selecione tipo:

Colar (Image 128x64 HEX)

Selecione o arquivo ou Cole o código em intelHex:

Converter Converter + Append

SAÍDA - Hex string:

Convert

----------------------------------- Utils -----------------------------------

Convert Dec To Hex
