diego123cruz/Z80Mini/Schematic/Z80 Mini - All boards.PDF

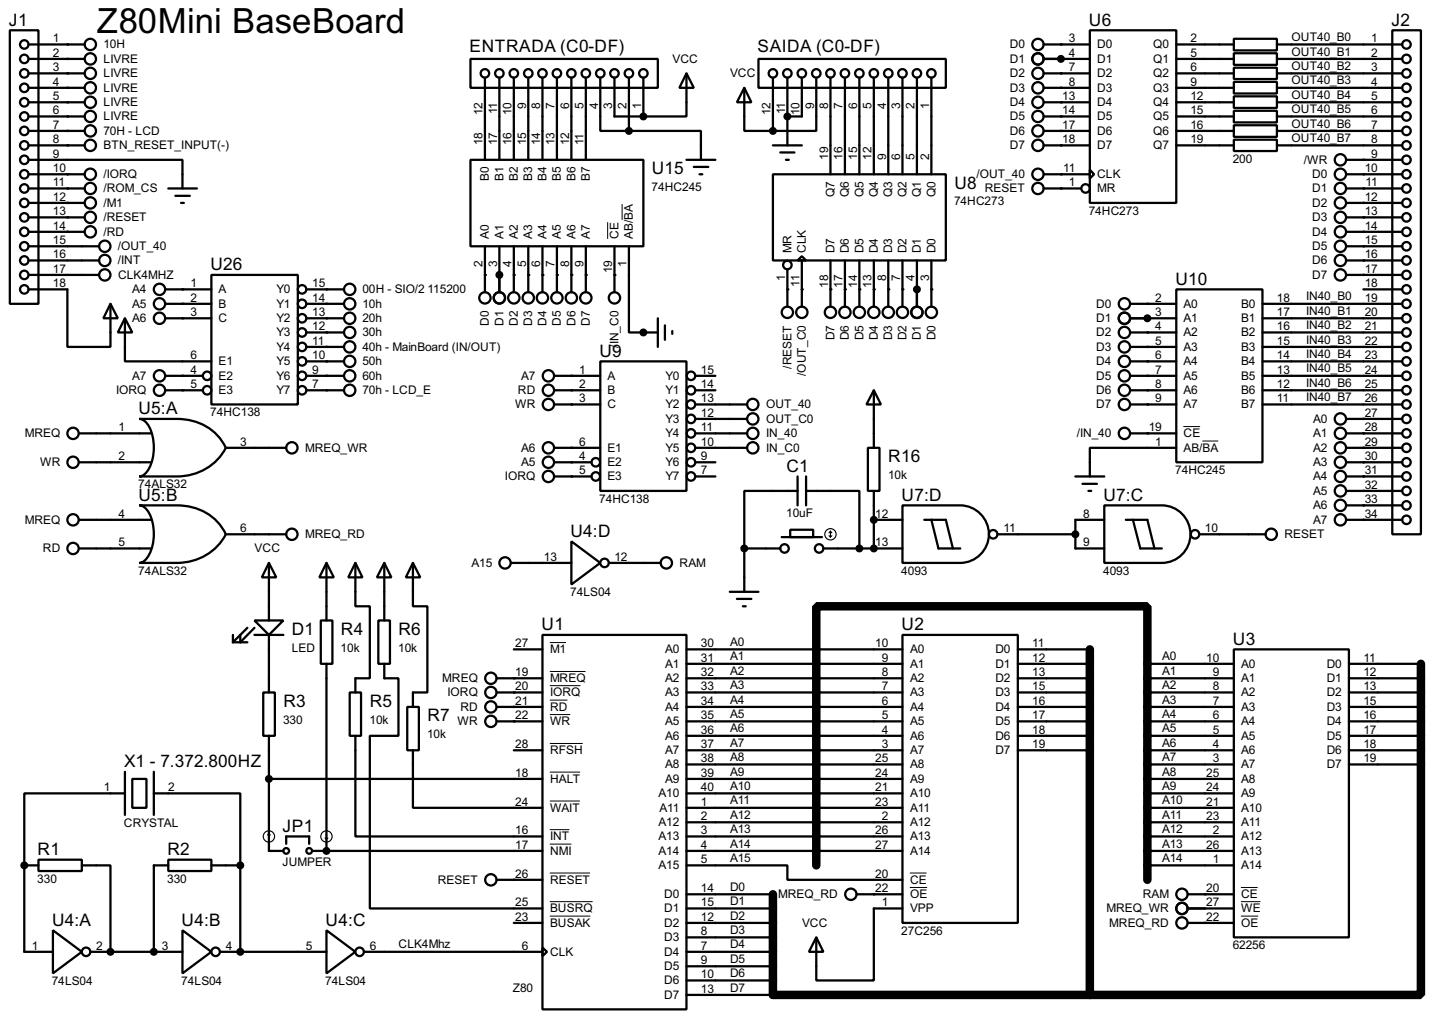
[picture p54: page 1]

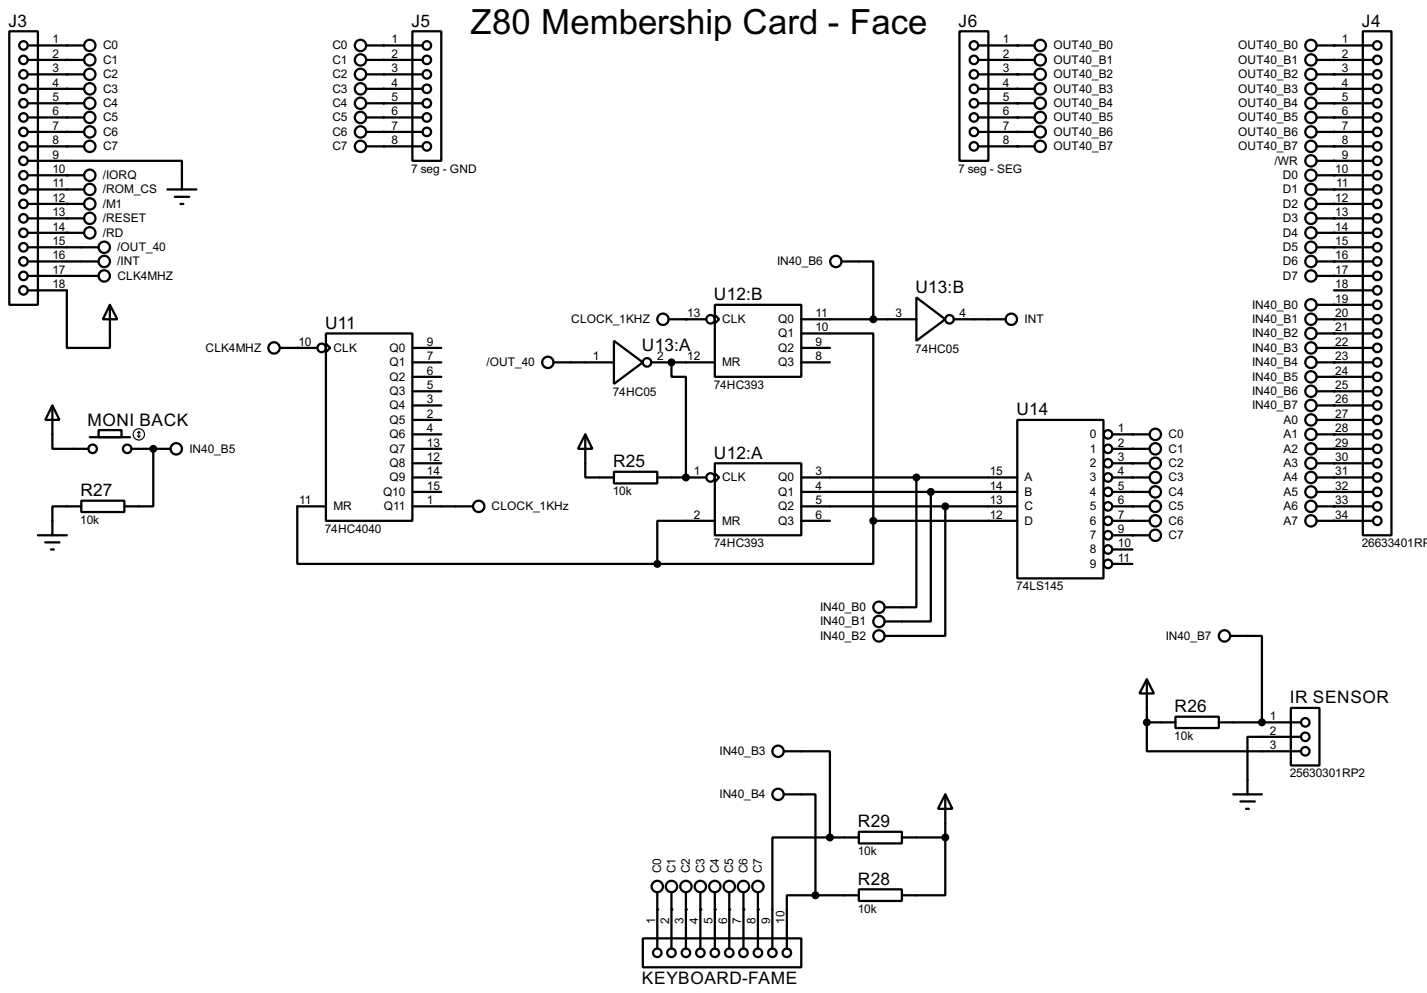
[picture p55: page 2]

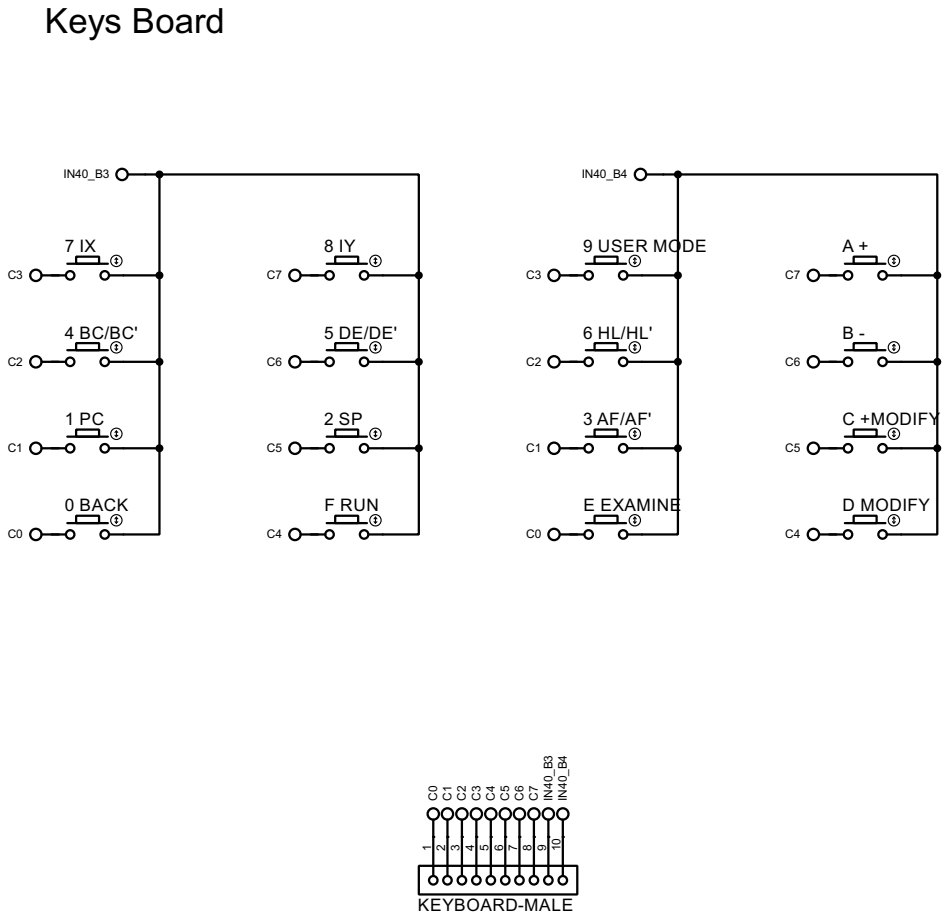
[picture p56: page 3]

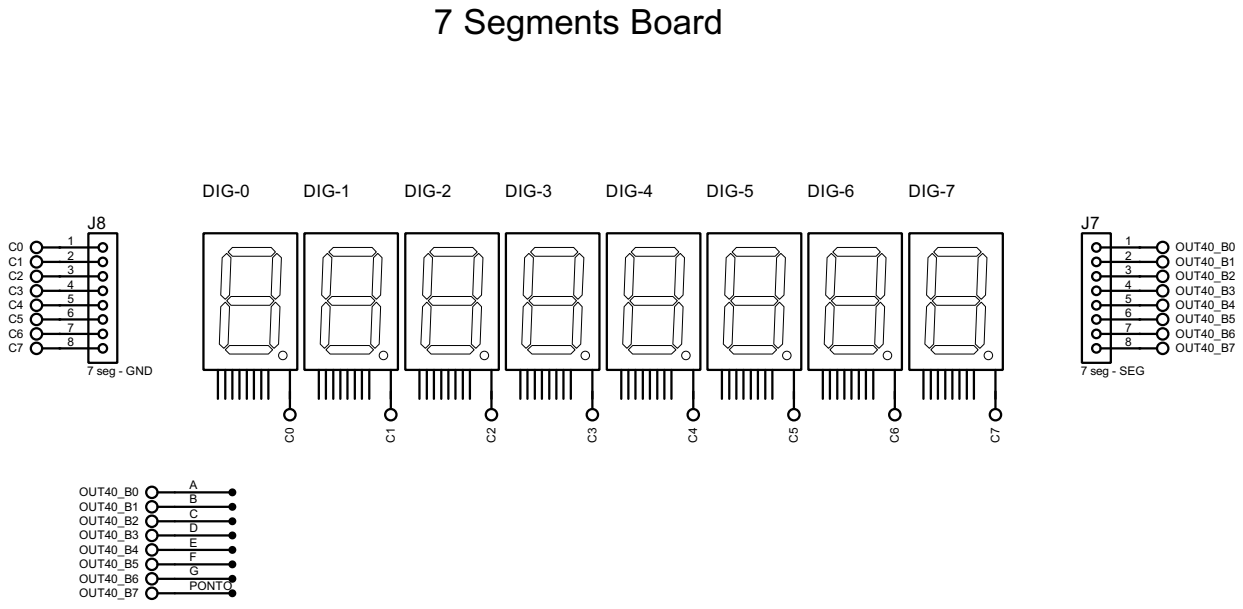
[picture p57: page 4]

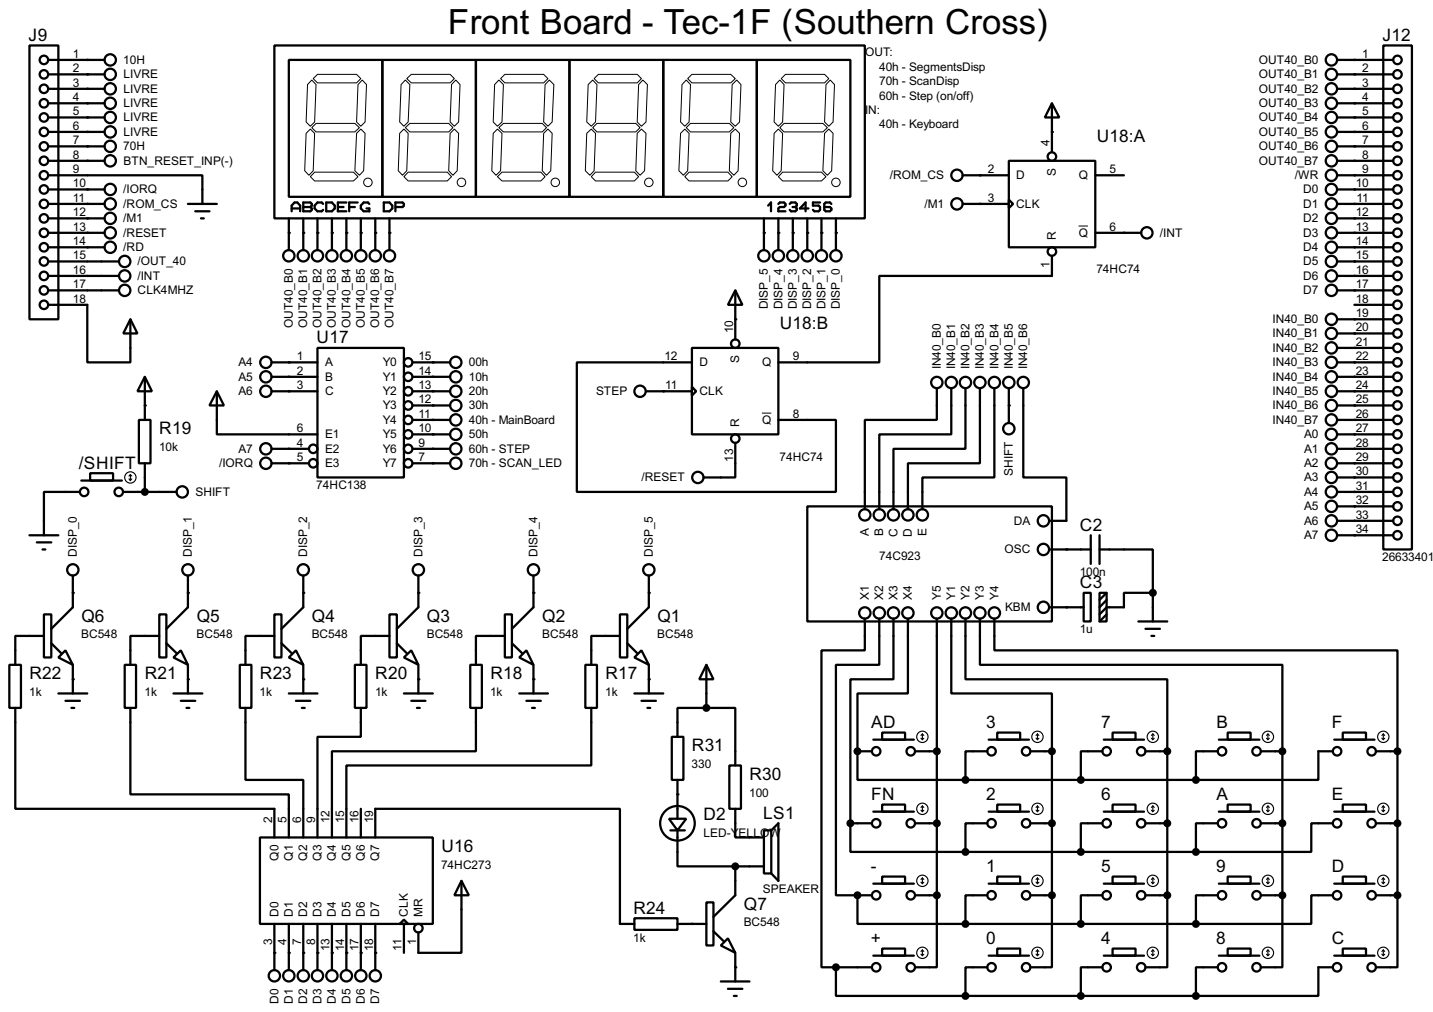
[picture p58: page 5]

Front Board - Tec-1F (Southern Cross)

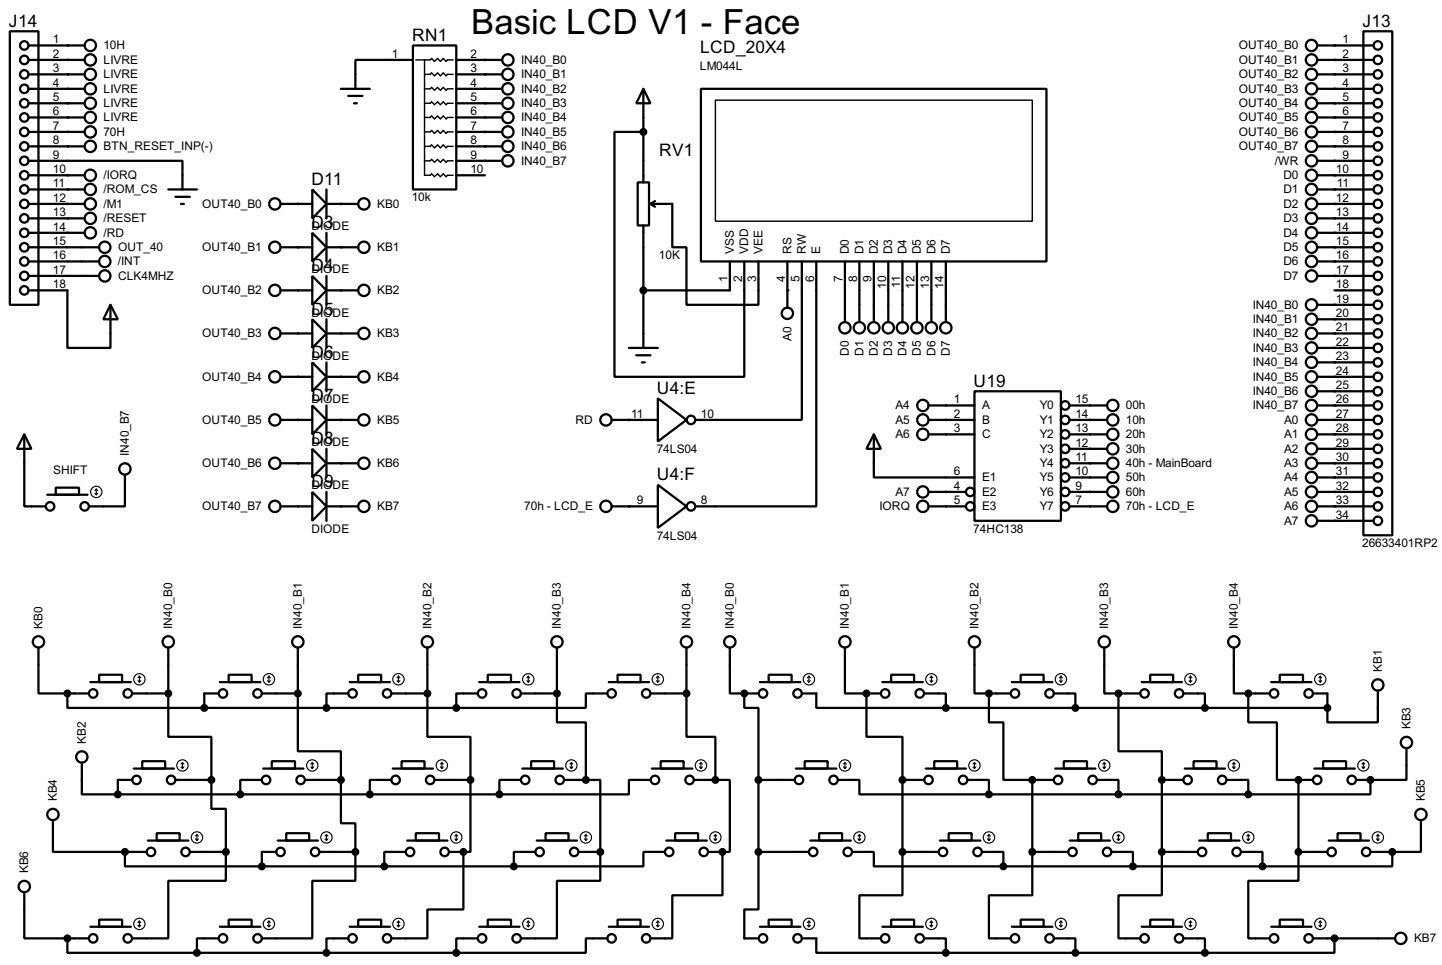
[picture p59: page 6]

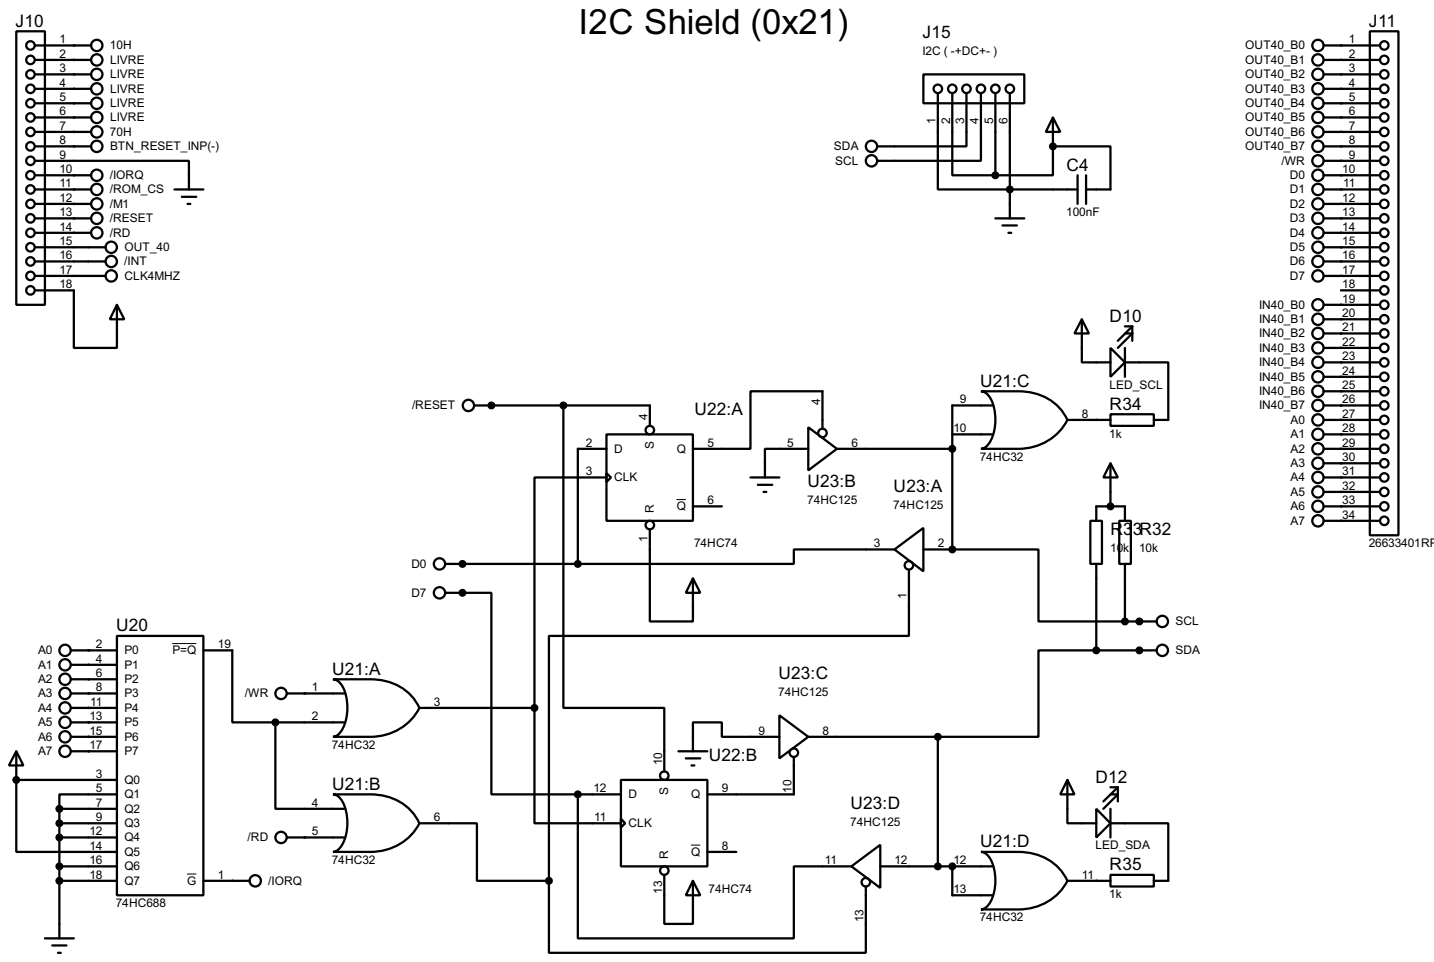
[picture p60: page 7]

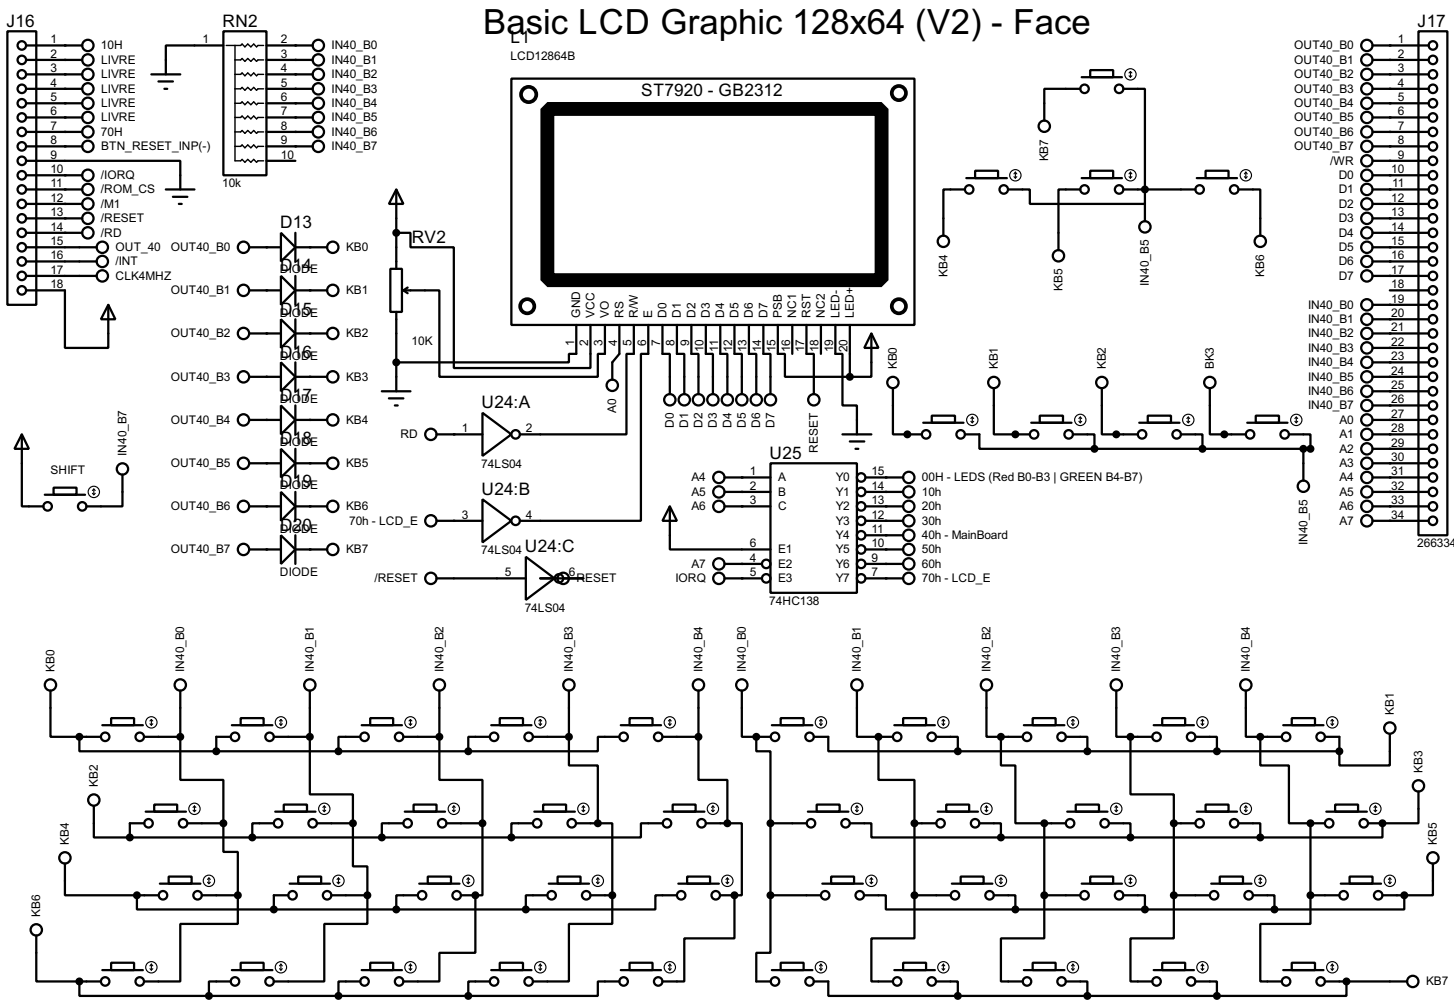
[picture p61: page 8]

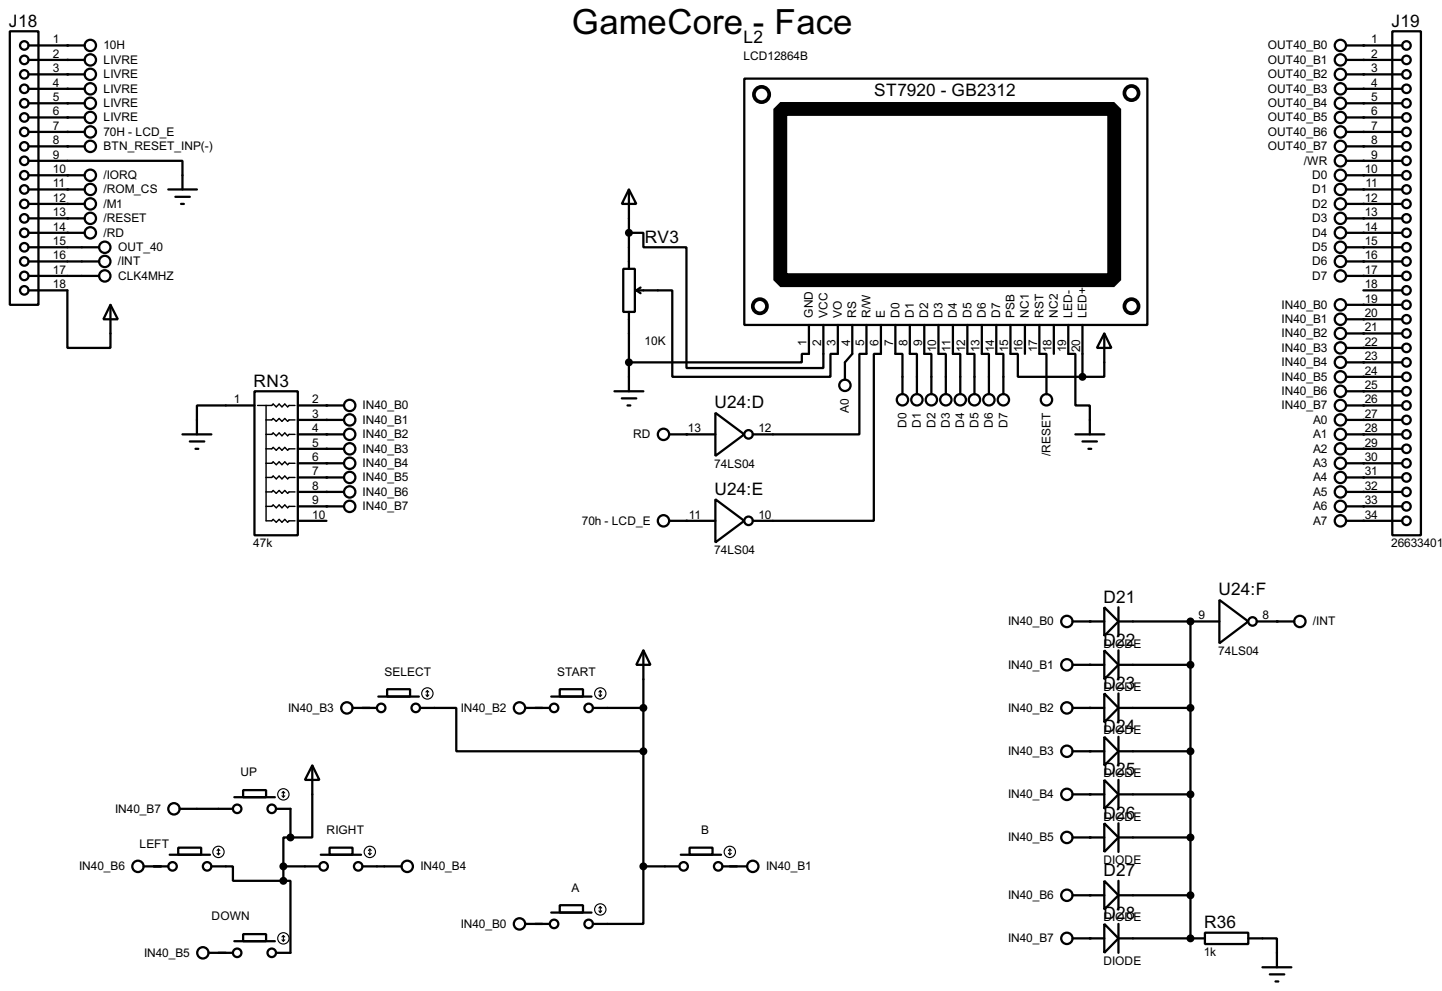
[picture p62: page 9]
