diego123cruz/Z80Mini/Schematic/Z80Mini-Core.PDF

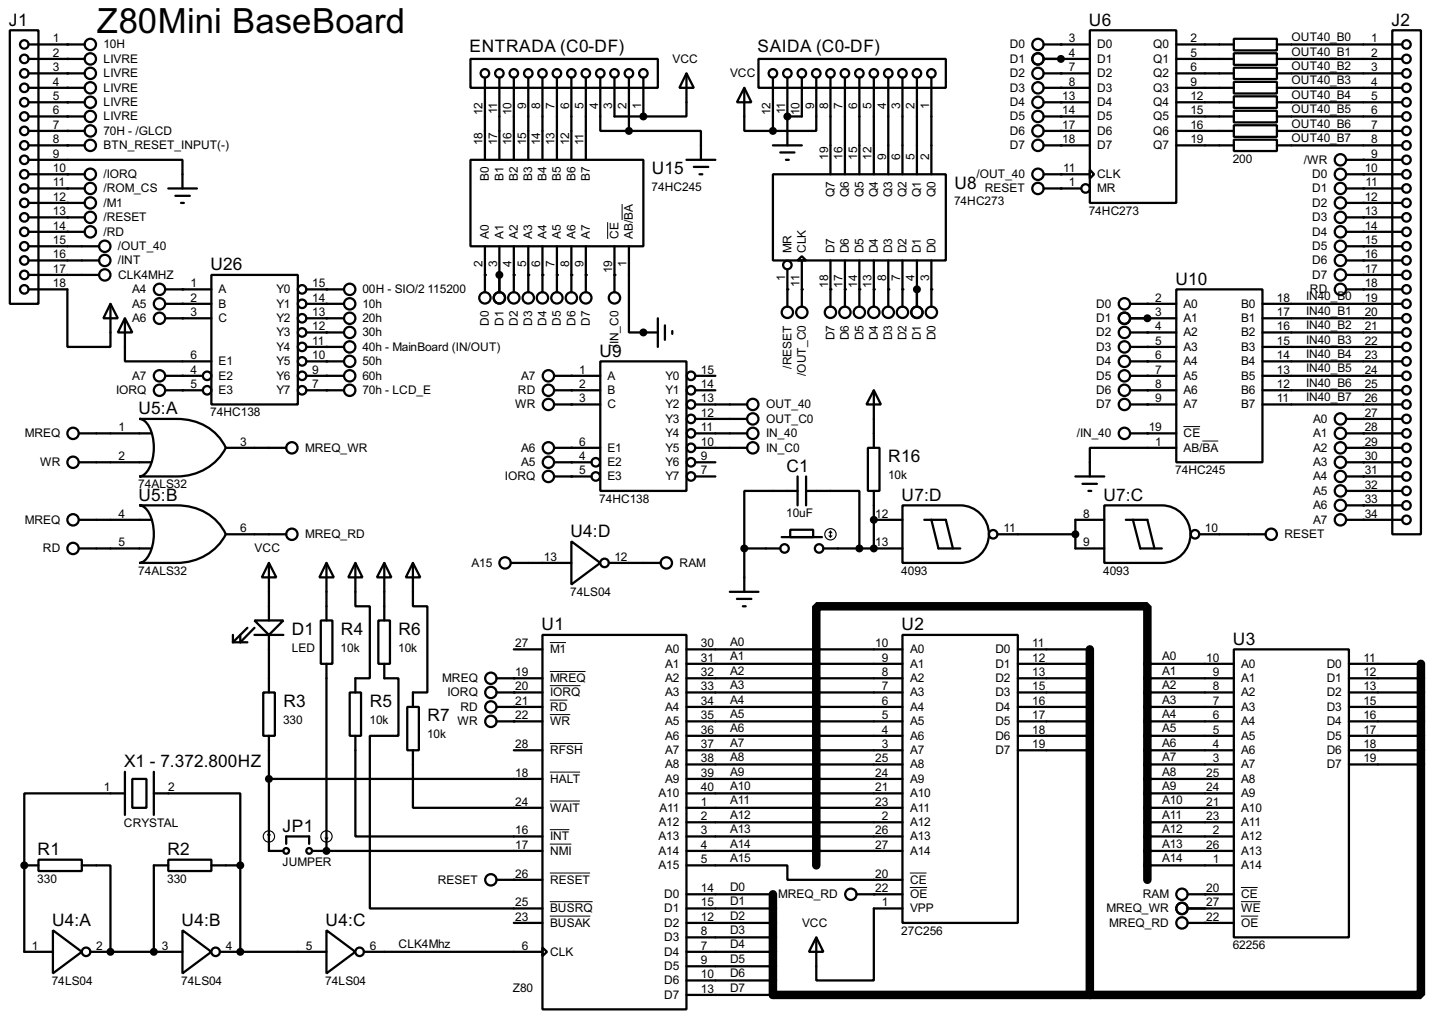
[picture p75: page 1]
