diego123cruz/Z80Mini/(list of files, drawings)

Other design files:
Schematic/Proteus 8.6 SP2/Z80Mini.pdsprj
