diego123cruz/Z80Mini/Graphics Display + Keyboard 65 - Face/bbcbasic-z80/main.asm

;	TITLE	BBC BASIC (C) R.T.RUSSELL 1987
;
;BBC BASIC INTERPRETER - Z80 VERSION
;COMMAND, ERROR AND LEXICAL ANALYSIS MODULE - "MAIN"
;(C) COPYRIGHT  R.T.RUSSELL  1984
;VERSION 2.3, 07-05-1984
;VERSION 3.0, 01-03-1987
;
	EXTERN	XEQ
	EXTERN	RUN0
	EXTERN	CHAIN0
	EXTERN	TERMQ
	EXTERN	MUL16
	EXTERN	X4OR5
	EXTERN	FILL
	EXTERN	ESCAPE
	EXTERN	CHECK
	EXTERN	SEARCH
;
	EXTERN	OSWRCH
	EXTERN	OSLINE
	EXTERN	OSINIT
	EXTERN	OSLOAD
	EXTERN	OSSAVE
	EXTERN	OSBGET
	EXTERN	OSBPUT
	EXTERN	OSSHUT
	EXTERN	OSSTAT
	EXTERN	PROMPT
	EXTERN	LTRAP
	EXTERN	OSCLI
	EXTERN	RESET
;
	EXTERN	COMMA
	EXTERN	BRAKET
	EXTERN	NXT
	EXTERN	ZERO
	EXTERN	ITEMI
	EXTERN	EXPRI
	EXTERN	EXPRS
	EXTERN	DECODE
	EXTERN	LOADN
	EXTERN	SFIX
;
	PUBLIC	START
	PUBLIC	OUTCHR
	PUBLIC	OUT
	PUBLIC	ERROR
	PUBLIC	EXTERR
	PUBLIC	REPORT
	PUBLIC	CLOOP
	PUBLIC	WARM
	PUBLIC	NEW
	PUBLIC	OLD
	PUBLIC	LOAD
	PUBLIC	SAVE
	PUBLIC	RENUM
	PUBLIC	AUTO
	PUBLIC	CLEAR
	PUBLIC	CRLF
	PUBLIC	SAYLN
	PUBLIC	LOAD0
	PUBLIC	TELL
	PUBLIC	FINDL
	PUBLIC	SETLIN
	PUBLIC	LIST
	PUBLIC	DELETE
	PUBLIC	GETVAR
	PUBLIC	PUTVAR
	PUBLIC	GETDEF
	PUBLIC	CREATE
	PUBLIC	PBCDL
	PUBLIC	LEXAN2
	PUBLIC	RANGE
;
	EXTERN	PAGE
	EXTERN	ACCS
	EXTERN	BUFFER
	EXTERN	LINENO
	EXTERN	LOMEM
	EXTERN	HIMEM
	EXTERN	COUNT
	EXTERN	WIDTH
	EXTERN	TOP
	EXTERN	FREE
	EXTERN	STAVAR
	EXTERN	DYNVAR
	EXTERN	ERRTXT
	EXTERN	ERR
	EXTERN	ERL
	EXTERN	ERRLIN
	EXTERN	ERRTRP
	EXTERN	FNPTR
	EXTERN	PROPTR
	EXTERN	AUTONO
	EXTERN	INCREM
	EXTERN	LISTON
	EXTERN	TRACEN
;
	ORG		2000H
;
TERROR: EQU 85H
LINE: EQU 86H
ELSE:	EQU	8BH
THEN:	EQU	8CH
LINO:	EQU	8DH
FN:	EQU	0A4H
TO:	EQU	0B8H
REN:	EQU	0CCH
DATA:	EQU	0DCH
DIM:	EQU	0DEH
FOR:	EQU	0E3H
GOSUB:	EQU	0E4H
GOTO:	EQU	0E5H
TIF:	EQU	0E7H
LOCAL:	EQU	0EAH
NEXT:	EQU	0EDH
ON:	EQU	0EEH
PROC:	EQU	0F2H
REM:	EQU	0F4H
REPEAT:	EQU	0F5H
RESTOR:	EQU	0F7H
TRACE:	EQU	0FCH
UNTIL:	EQU	0FDH
;
TOKLO:	EQU	8FH
TOKHI:	EQU	93H
OFFSET:	EQU	0CFH-TOKLO
;
START:	JP	COLD
	JP	WARM
	JP	ESCAPE
	JP	EXTERR
	JP	TELL
	JP	TEXT
	JP	SETTOP
	JP	CLEAR
	JP	RUN0
	JP	OSCLI
	JP	OSBGET
	JP	OSBPUT
	JP	OSSTAT
	JP	OSSHUT
COLD:	LD	HL,STAVAR	;COLD START
	LD	SP,HL
	LD	(HL),10
	INC	L
	LD	(HL),9
	INC	L
	XOR	A
PURGE:	LD	(HL),A		;CLEAR SCRATCHPAD
	INC	L
	JR	NZ,PURGE
	LD	A,37H		;V3.0
	LD	(LISTON),A
	LD	HL,NOTICE
	LD	(ERRTXT),HL
	CALL	OSINIT
	LD	(HIMEM),DE
	LD	(PAGE),HL
	CALL	NEWIT
	;JP	NZ,CHAIN0	;AUTO-RUN
	CALL	TELL
	DEFM	"BBC BASIC (Z80) Version 3.00  "
	DEFB	CR
	DEFB	LF
NOTICE:	DEFM	"(C) Copyright R.T.Russell 1987"
	DEFB	CR
	DEFB	LF
	DEFB	0
WARM:	DEFB	0F6H
CLOOP:	SCF
	LD	SP,(HIMEM)
	CALL	PROMPT		;PROMPT USER
	LD	HL,LISTON
	LD	A,(HL)
	AND	0FH		;LISTO
	OR	30H		;OPT 3
	LD	(HL),A
	SBC	HL,HL		;HL <- 0 (V3.0)
	LD	(ERRTRP),HL
	LD	(ERRLIN),HL
	LD	HL,(AUTONO)
	LD	(LINENO),HL
	LD	A,H
	OR	L
	JR	Z,NOAUTO
	PUSH	HL
	CALL	PBCD		;AUTO NUMBER
	POP	HL
	LD	BC,(INCREM)
	LD	B,0
	ADD	HL,BC
	JP	C,TOOBIG
	LD	(AUTONO),HL
	LD	A,' '
	CALL	OUTCHR
NOAUTO:	LD	HL,ACCS
	CALL	OSLINE		;GET CONSOLE INPUT
	XOR	A
	LD	(COUNT),A
	LD	IY,ACCS
	CALL	LINNUM
	CALL	NXT
	LD	A,H
	OR	L
	JR	Z,LNZERO	;FOR AUTO (NON-MAPPED)
	LD	(LINENO),HL
LNZERO:	LD	DE,BUFFER
	LD	C,1		;LEFT MODE
	CALL	LEXAN2		;LEXICAL ANALYSIS
	LD	(DE),A		;TERMINATOR
	XOR	A
	LD	B,A
	LD	C,E		;BC=LINE LENGTH
	INC	DE
	LD	(DE),A		;ZERO NEXT
	LD	HL,(LINENO)
	LD	A,H
	OR	L
	LD	IY,BUFFER	;FOR XEQ
	JP	Z,XEQ		;DIRECT MODE
	PUSH	BC
	PUSH	HL
	CALL	SETTOP		;SET TOP
	POP	HL
	CALL	FINDL
	CALL	Z,DEL
	POP	BC
	LD	A,C
	OR	A
	JP	Z,CLOOP		;DELETE LINE ONLY
	ADD	A,4
	LD	C,A		;LENGTH INCLUSIVE
	PUSH	DE		;LINE NUMBER
	PUSH	BC		;SAVE LINE LENGTH
	EX	DE,HL
	LD	HL,(TOP)
	PUSH	HL
	ADD	HL,BC
	PUSH	HL
	INC	H
	XOR	A
	SBC	HL,SP
	POP	HL
	JP	NC,ERROR	;"No room"
	LD	(TOP),HL
	EX	(SP),HL
	PUSH	HL
	INC	HL
	OR	A
	SBC	HL,DE
	LD	B,H		;BC=AMOUNT TO MOVE
	LD	C,L
	POP	HL
	POP	DE
	JR	Z,ATEND
	LDDR			;MAKE SPACE
ATEND:	POP	BC		;LINE LENGTH
	POP	DE		;LINE NUMBER
	INC	HL
	LD	(HL),C		;STORE LENGTH
	INC	HL
	LD	(HL),E		;STORE LINE NUMBER
	INC	HL
	LD	(HL),D
	INC	HL
	LD	DE,BUFFER
	EX	DE,HL
	DEC	C
	DEC	C
	DEC	C
	LDIR			;ADD LINE
	CALL	CLEAN
	JP	CLOOP
;
;LIST OF TOKENS AND KEYWORDS.
;IF A KEYWORD IS FOLLOWED BY NUL THEN IT WILL
; ONLY MATCH WITH THE WORD FOLLOWED IMMEDIATELY
; BY A DELIMITER.
;
KEYWDS:	DEFB	80H
	DEFM	"AND"
	DEFB	94H
	DEFM	"ABS"
	DEFB	95H
	DEFM	"ACS"
	DEFB	96H
	DEFM	"ADVAL"
	DEFB	97H
	DEFM	"ASC"
	DEFB	98H
	DEFM	"ASN"
	DEFB	99H
	DEFM	"ATN"
	DEFB	0C6H
	DEFM	"AUTO"
	DEFB	9AH
	DEFM	"BGET"
	DEFB	0
	DEFB	0D5H
	DEFM	"BPUT"
	DEFB	0
	DEFB	0FBH
	DEFM	"COLOUR"
	DEFB	0FBH
	DEFM	"COLOR"
	DEFB	0D6H
	DEFM	"CALL"
	DEFB	0D7H
	DEFM	"CHAIN"
	DEFB	0BDH
	DEFM	"CHR$"
	DEFB	0D8H
	DEFM	"CLEAR"
	DEFB	0
	DEFB	0D9H
	DEFM	"CLOSE"
	DEFB	0
	DEFB	0DAH
	DEFM	"CLG"
	DEFB	0
	DEFB	0DBH
	DEFM	"CLS"
	DEFB	0
	DEFB	9BH
	DEFM	"COS"
	DEFB	9CH
	DEFM	"COUNT"
	DEFB	0
	DEFB	0DCH
	DEFM	"DATA"
	DEFB	9DH
	DEFM	"DEG"
	DEFB	0DDH
	DEFM	"DEF"
	DEFB	0C7H
	DEFM	"DELETE"
	DEFB	81H
	DEFM	"DIV"
	DEFB	0DEH
	DEFM	"DIM"
	DEFB	0DFH
	DEFM	"DRAW"
	DEFB	0E1H
	DEFM	"ENDPROC"
	DEFB	0
	DEFB	0E0H
	DEFM	"END"
	DEFB	0
	DEFB	0E2H
	DEFM	"ENVELOPE"
	DEFB	8BH
	DEFM	"ELSE"
	DEFB	0A0H
	DEFM	"EVAL"
	DEFB	9EH
	DEFM	"ERL"
	DEFB	0
	DEFB	85H
	DEFM	"ERROR"
	DEFB	0C5H
	DEFM	"EOF"
	DEFB	0
	DEFB	82H
	DEFM	"EOR"
	DEFB	9FH
	DEFM	"ERR"
	DEFB	0
	DEFB	0A1H
	DEFM	"EXP"
	DEFB	0A2H
	DEFM	"EXT"
	DEFB	0
	DEFB	0E3H
	DEFM	"FOR"
	DEFB	0A3H
	DEFM	"FALSE"
	DEFB	0
	DEFB	0A4H
	DEFM	"FN"
	DEFB	0E5H
	DEFM	"GOTO"
	DEFB	0BEH
	DEFM	"GET$"
	DEFB	0A5H
	DEFM	"GET"
	DEFB	0E4H
	DEFM	"GOSUB"
	DEFB	0E6H
	DEFM	"GCOL"
	DEFB	93H
	DEFM	"HIMEM"
	DEFB	0
	DEFB	0E8H
	DEFM	"INPUT"
	DEFB	0E7H
	DEFM	"IF"
	DEFB	0BFH
	DEFM	"INKEY$"
	DEFB	0A6H
	DEFM	"INKEY"
	DEFB	0A8H
	DEFM	"INT"
	DEFB	0A7H
	DEFM	"INSTR("
	DEFB	0C9H
	DEFM	"LIST"
	DEFB	86H
	DEFM	"LINE"
	DEFB	0C8H
	DEFM	"LOAD"
	DEFB	92H
	DEFM	"LOMEM"
	DEFB	0
	DEFB	0EAH
	DEFM	"LOCAL"
	DEFB	0C0H
	DEFM	"LEFT$("
	DEFB	0A9H
	DEFM	"LEN"
	DEFB	0E9H
	DEFM	"LET"
	DEFB	0ABH
	DEFM	"LOG"
	DEFB	0AAH
	DEFM	"LN"
	DEFB	0C1H
	DEFM	"MID$("
	DEFB	0EBH
	DEFM	"MODE"
	DEFB	83H
	DEFM	"MOD"
	DEFB	0ECH
	DEFM	"MOVE"
	DEFB	0EDH
	DEFM	"NEXT"
	DEFB	0CAH
	DEFM	"NEW"
	DEFB	0
	DEFB	0ACH
	DEFM	"NOT"
	DEFB	0CBH
	DEFM	"OLD"
	DEFB	0
	DEFB	0EEH
	DEFM	"ON"
	DEFB	87H
	DEFM	"OFF"
	DEFB	84H
	DEFM	"OR"
	DEFB	8EH
	DEFM	"OPENIN"
	DEFB	0AEH
	DEFM	"OPENOUT"
	DEFB	0ADH
	DEFM	"OPENUP"
	DEFB	0FFH
	DEFM	"OSCLI"
	DEFB	0F1H
	DEFM	"PRINT"
	DEFB	90H
	DEFM	"PAGE"
	DEFB	0
	DEFB	8FH
	DEFM	"PTR"
	DEFB	0
	DEFB	0AFH
	DEFM	"PI"
	DEFB	0
	DEFB	0F0H
	DEFM	"PLOT"
	DEFB	0B0H
	DEFM	"POINT("
	DEFB	0F2H
	DEFM	"PROC"
	DEFB	0B1H
	DEFM	"POS"
	DEFB	0
	DEFB	0CEH
	DEFM	"PUT"
	DEFB	0F8H
	DEFM	"RETURN"
	DEFB	0
	DEFB	0F5H
	DEFM	"REPEAT"
	DEFB	0F6H
	DEFM	"REPORT"
	DEFB	0
	DEFB	0F3H
	DEFM	"READ"
	DEFB	0F4H
	DEFM	"REM"
	DEFB	0F9H
	DEFM	"RUN"
	DEFB	0
	DEFB	0B2H
	DEFM	"RAD"
	DEFB	0F7H
	DEFM	"RESTORE"
	DEFB	0C2H
	DEFM	"RIGHT$("
	DEFB	0B3H
	DEFM	"RND"
	DEFB	0
	DEFB	0CCH
	DEFM	"RENUMBER"
	DEFB	88H
	DEFM	"STEP"
	DEFB	0CDH
	DEFM	"SAVE"
	DEFB	0B4H
	DEFM	"SGN"
	DEFB	0B5H
	DEFM	"SIN"
	DEFB	0B6H
	DEFM	"SQR"
	DEFB	89H
	DEFM	"SPC"
	DEFB	0C3H
	DEFM	"STR$"
	DEFB	0C4H
	DEFM	"STRING$("
	DEFB	0D4H
	DEFM	"SOUND"
	DEFB	0FAH
	DEFM	"STOP"
	DEFB	0
	DEFB	0B7H
	DEFM	"TAN"
	DEFB	8CH
	DEFM	"THEN"
	DEFB	0B8H
	DEFM	"TO"
	DEFB	8AH
	DEFM	"TAB("
	DEFB	0FCH
	DEFM	"TRACE"
	DEFB	91H
	DEFM	"TIME"
	DEFB	0
	DEFB	0B9H
	DEFM	"TRUE"
	DEFB	0
	DEFB	0FDH
	DEFM	"UNTIL"
	DEFB	0BAH
	DEFM	"USR"
	DEFB	0EFH
	DEFM	"VDU"
	DEFB	0BBH
	DEFM	"VAL"
	DEFB	0BCH
	DEFM	"VPOS"
	DEFB	0
	DEFB	0FEH
	DEFM	"WIDTH"
	DEFB	0D3H
	DEFM	"HIMEM"
	DEFB	0D2H
	DEFM	"LOMEM"
	DEFB	0D0H
	DEFM	"PAGE"
	DEFB	0CFH
	DEFM	"PTR"
	DEFB	0D1H
	DEFM	"TIME"
	DEFB	1
	DEFM	"Missing "
	DEFB	2
	DEFM	"No such "
	DEFB	3
	DEFM	"Bad "
	DEFB	4
	DEFM	" range"
	DEFB	5
	DEFM	"variable"
	DEFB	6
	DEFM	"Out of"
	DEFB	7
	DEFM	"No "
	DEFB	8
	DEFM	" space"
KEYWDL	EQU	$-KEYWDS
	DEFW	-1
;
;ERROR MESSAGES:
;
ERRWDS:	DEFB	7
	DEFM	"room"
	DEFB	0
	DEFB	6
	DEFB	4
	DEFB	0
	DEFW	0
	DEFM	"Mistake"
	DEFB	0
	DEFB	1
	DEFM	","
	DEFB	0
	DEFM	"Type mismatch"
	DEFB	0
	DEFB	7
	DEFB	FN
	DEFW	0
	DEFB	1
	DEFM	'"' ;"
	DEFB	0
	DEFB	3
	DEFB	DIM
	DEFB	0
	DEFB	DIM
	DEFB	8
	DEFB	0
	DEFM	"Not "
	DEFB	LOCAL
	DEFB	0
	DEFB	7
	DEFB	PROC
	DEFB	0
	DEFM	"Array"
	DEFB	0
	DEFM	"Subscript"
	DEFB	0
	DEFM	"Syntax error"
	DEFB	0
	DEFM	"Escape"
	DEFB	0
	DEFM	"Division by zero"
	DEFB	0
	DEFM	"String too long"
	DEFB	0
	DEFM	"Too big"
	DEFB	0
	DEFM	"-ve root"
	DEFB	0
	DEFM	"Log"
	DEFB	4
	DEFB	0
	DEFM	"Accuracy lost"
	DEFB	0
	DEFM	"Exp"
	DEFB	4
	DEFW	0
	DEFB	2
	DEFB	5
	DEFB	0
	DEFB	1
	DEFM	")"
	DEFB	0
	DEFB	3
	DEFM	"HEX"
	DEFB	0
	DEFB	2
	DEFB	FN
	DEFM	"/"
	DEFB	PROC
	DEFB	0
	DEFB	3
	DEFM	"call"
	DEFB	0
	DEFM	"Arguments"
	DEFB	0
	DEFB	7
	DEFB	FOR
	DEFB	0
	DEFM	"Can't match "
	DEFB	FOR
	DEFB	0
	DEFB	FOR
	DEFM	" "
	DEFB	5
	DEFW	0
	DEFB	7
	DEFB	TO
	DEFW	0
	DEFB	7
	DEFB	GOSUB
	DEFB	0
	DEFB	ON
	DEFM	" syntax"
	DEFB	0
	DEFB	ON
	DEFB	4
	DEFB	0
	DEFB	2
	DEFM	"line"
	DEFB	0
	DEFB	6
	DEFM	" "
	DEFB	DATA
	DEFB	0
	DEFB	7
	DEFB	REPEAT
	DEFW	0
	DEFB	1
	DEFM	"#"
	DEFB	0
;
;COMMANDS:
;
;DELETE line,line
;
DELETE:	CALL	SETTOP		;SET TOP
	CALL	DLPAIR
DELET1:	LD	A,(HL)
	OR	A
	JR	Z,WARMNC
	INC	HL
	LD	E,(HL)
	INC	HL
	LD	D,(HL)
	LD	A,D
	OR	E
	JR	Z,CLOOP1	;LINE NUMBER ZERO
	DEC	HL
	DEC	HL
	EX	DE,HL
	SCF
	SBC	HL,BC
	EX	DE,HL
	JR	NC,WARMNC
	PUSH	BC
	CALL	DEL
	POP	BC
	JR	DELET1
;
;LISTO expr
;
LISTO:	INC	IY		;SKIP "O"
	CALL	EXPRI
	EXX
	LD	A,L
	LD	(LISTON),A
CLOOP1:	JP	CLOOP
;
;LIST
;LIST line
;LIST line,line [IF string]
;LIST ,line
;LIST line,
;
LIST:	CP	'O'
	JR	Z,LISTO
	CALL	DLPAIR
	CALL	NXT
	CP	TIF		;IF CLAUSE ?
	LD	A,0		;INIT IF-CLAUSE LENGTH
	JR	NZ,LISTB
	INC	IY		;SKIP IF
	CALL	NXT		;SKIP SPACES (IF ANY)
	EX	DE,HL
	PUSH	IY
	POP	HL		;HL ADDRESSES IF CLAUSE
	LD	A,CR
	PUSH	BC
	LD	BC,256
	CPIR			;LOCATE CR
	LD	A,C
	CPL			;A = SUBSTRING LENGTH
	POP	BC
	EX	DE,HL
LISTB:	LD	E,A		;IF-CLAUSE LENGTH
	LD	A,B
	OR	C
	JR	NZ,LISTA
	DEC	BC
LISTA:	EXX
	LD	IX,LISTON
	LD	BC,0		;INDENTATION COUNT
	EXX
	LD	A,20
;
LISTC:	PUSH	BC		;SAVE HIGH LINE NUMBER
	PUSH	DE		;SAVE IF-CLAUSE LENGTH
	PUSH	HL		;SAVE PROGRAM POINTER
	EX	AF,AF'
	LD	A,(HL)
	OR	A
	JR	Z,WARMNC
;
;CHECK IF PAST TERMINATING LINE NUMBER:
;
	LD	A,E		;A = IF-CLAUSE LENGTH
	INC	HL
	LD	E,(HL)
	INC	HL
	LD	D,(HL)		;DE = LINE NUMBER
	DEC	HL
	DEC	HL
	PUSH	DE		;SAVE LINE NUMBER
	EX	DE,HL
	SCF
	SBC	HL,BC
	EX	DE,HL
	POP	DE		;RESTORE LINE NUMBER
WARMNC:	JP	NC,WARM
	LD	C,(HL)		;C = LINE LENGTH + 4
	LD	B,A		;B = IF-CLAUSE LENGTH
;
;CHECK IF "UNLISTABLE":
;
	LD	A,D
	OR	E
	JP	Z,CLOOP
;
;CHECK FOR IF CLAUSE:
;
	INC	HL
	INC	HL
	INC	HL		;HL ADDRESSES LINE TEXT
	DEC	C
	DEC	C
	DEC	C
	DEC	C		;C = LINE LENGTH
	PUSH	DE		;SAVE LINE NUMBER
	PUSH	HL		;SAVE LINE ADDRESS
	XOR	A		;A <- 0
	CP	B		;WAS THERE AN IF-CLAUSE
	PUSH	IY
	POP	DE		;DE ADDRESSES IF-CLAUSE
	CALL	NZ,SEARCH	;SEARCH FOR IF CLAUSE
	POP	HL		;RESTORE LINE ADDRESS
	POP	DE		;RESTORE LINE NUMBER
	PUSH	IY
	CALL	Z,LISTIT	;LIST IF MATCH
	POP	IY
;
	EX	AF,AF'
	DEC	A
	CALL	LTRAP
	POP	HL		;RESTORE POINTER
	LD	E,(HL)
	LD	D,0
	ADD	HL,DE		;ADDRESS NEXT LINE
	POP	DE		;RESTORE IF-CLAUSE LEN
	POP	BC		;RESTORE HI LINE NUMBER
	JR	LISTC
;
;RENUMBER
;RENUMBER start
;RENUMBER start,increment
;RENUMBER ,increment
;
RENUM:	CALL	CLEAR		;USES DYNAMIC AREA
	CALL	PAIR		;LOAD HL,BC
	EXX
	LD	HL,(PAGE)
	LD	DE,(LOMEM)
RENUM1:	LD	A,(HL)		;BUILD TABLE
	OR	A
	JR	Z,RENUM2
	INC	HL
	LD	C,(HL)		;OLD LINE NUMBER
	INC	HL
	LD	B,(HL)
	LD	A,B
	OR	C
	JP	Z,CLOOP		;LINE NUMBER ZERO
	EX	DE,HL
	LD	(HL),C
	INC	HL
	LD	(HL),B
	INC	HL
	EXX
	PUSH	HL
	ADD	HL,BC		;ADD INCREMENT
	JP	C,TOOBIG	;"Too big"
	EXX
	POP	BC
	LD	(HL),C
	INC	HL
	LD	(HL),B
	INC	HL
	EX	DE,HL
	DEC	HL
	DEC	HL
	XOR	A
	LD	B,A
	LD	C,(HL)
	ADD	HL,BC		;NEXT LINE
	EX	DE,HL
	PUSH	HL
	INC	H
	SBC	HL,SP
	POP	HL
	EX	DE,HL
	JR	C,RENUM1	;CONTINUE
	CALL	EXTERR		;"RENUMBER space"
	DEFB	REN
	DEFB	8
	DEFB	0
;
RENUM2:	EX	DE,HL
	LD	(HL),-1
	INC	HL
	LD	(HL),-1
	LD	DE,(LOMEM)
	EXX
	LD	HL,(PAGE)
RENUM3:	LD	C,(HL)
	LD	A,C
	OR	A
	JP	Z,WARM
	EXX
	EX	DE,HL
	INC	HL
	INC	HL
	LD	E,(HL)
	INC	HL
	LD	D,(HL)
	INC	HL
	PUSH	DE
	EX	DE,HL
	LD	(LINENO),HL
	EXX
	POP	DE
	INC	HL
	LD	(HL),E		;NEW LINE NUMBER
	INC	HL
	LD	(HL),D
	INC	HL
	DEC	C
	DEC	C
	DEC	C
	LD	B,0
RENUM7:	LD	A,LINO
	CPIR			;SEARCH FOR LINE NUMBER
	JR	NZ,RENUM3
	PUSH	BC
	PUSH	HL
	PUSH	HL
	POP	IY
	EXX
	CALL	DECODE		;DECODE LINE NUMBER
	EXX
	LD	B,H
	LD	C,L
	LD	HL,(LOMEM)
RENUM4:	LD	E,(HL)		;CROSS-REFERENCE TABLE
	INC	HL
	LD	D,(HL)
	INC	HL
	EX	DE,HL
	OR	A		;CLEAR CARRY
	SBC	HL,BC
	EX	DE,HL
	LD	E,(HL)		;NEW NUMBER
	INC	HL
	LD	D,(HL)
	INC	HL
	JR	C,RENUM4
	EX	DE,HL
	JR	Z,RENUM5	;FOUND
	CALL	TELL
	DEFM	"Failed at "
	DEFB	0
	LD	HL,(LINENO)
	CALL	PBCDL
	CALL	CRLF
	JR	RENUM6
RENUM5:	POP	DE
	PUSH	DE
	DEC	DE
	CALL	ENCODE		;RE-WRITE NUMBER
RENUM6:	POP	HL
	POP	BC
	JR	RENUM7
;
;AUTO
;AUTO start,increment
;AUTO start
;AUTO ,increment
;
AUTO:	CALL	PAIR
	LD	(AUTONO),HL
	LD	A,C
	LD	(INCREM),A
	JR	CLOOP0
;
;BAD
;NEW
;
BAD:	CALL	TELL		;"Bad program"
	DEFB	3
	DEFM	"program"
	DEFB	CR
	DEFB	LF
	DEFB	0
NEW:	CALL	NEWIT
	JR	CLOOP0
;
;OLD
;
OLD:	LD	HL,(PAGE)
	PUSH	HL
	INC	HL
	INC	HL
	INC	HL
	LD	BC,252
	LD	A,CR
	CPIR
	JR	NZ,BAD
	LD	A,L
	POP	HL
	LD	(HL),A
	CALL	CLEAN
CLOOP0:	JP	CLOOP
;
;LOAD filename
;
LOAD:	CALL	EXPRS		;GET FILENAME
	LD	A,CR
	LD	(DE),A
	CALL	LOAD0
	CALL	CLEAR
	JR	WARM0
;
;SAVE filename
;
SAVE:	CALL	SETTOP		;SET TOP
	CALL	EXPRS		;FILENAME
	LD	A,CR
	LD	(DE),A
	LD	DE,(PAGE)
	LD	HL,(TOP)
	OR	A
	SBC	HL,DE
	LD	B,H		;LENGTH OF PROGRAM
	LD	C,L
	LD	HL,ACCS
	CALL	OSSAVE
WARM0:	JP	WARM
;
;ERROR
;
ERROR:	LD	SP,(HIMEM)
	LD	HL,ERRWDS
	OR	A
	JR	Z,ERROR1
	LD	B,A		;ERROR NUMBER
	EX	AF,AF'
	XOR	A
ERROR0:	CP	(HL)
	INC	HL
	JR	NZ,ERROR0
	DJNZ	ERROR0
	EX	AF,AF'
ERROR1:	PUSH	HL
EXTERR:	POP	HL
	LD	(ERRTXT),HL
	LD	SP,(HIMEM)
	LD	(ERR),A
	CALL	SETLIN
	LD	(ERL),HL
	OR	A
	JR	Z,ERROR2
	LD	HL,(ERRTRP)
	LD	A,H
	OR	L
	PUSH	HL
	POP	IY
	JP	NZ,XEQ		;ERROR TRAPPED
ERROR2:	LD	HL,0
	LD	(AUTONO),HL
	LD	(TRACEN),HL	;CANCEL TRACE
	CALL	RESET		;RESET OPSYS
	CALL	CRLF
	CALL	REPORT		;MESSAGE
	CALL	SAYLN
	LD	E,0
	CALL	C,OSSHUT	;CLOSE ALL FILES
	CALL	CRLF
	JP	CLOOP
;
;SUBROUTINES:
;
;
;LEX - SEARCH FOR KEYWORDS
;   Inputs: HL = start of keyword table
;           IY = start of match text
;  Outputs: If found, Z-flag set, A=token.
;           If not found, Z-flag reset, A=(IY).
;           IY updated (if NZ, IY unchanged).
; Destroys: A,B,H,L,IY,F
;
LEX:	LD	HL,KEYWDS
LEX0:	LD	A,(IY)
	LD	B,(HL)
	INC	HL
	CP	(HL)
	JR	Z,LEX2
	RET	C		;FAIL EXIT
LEX1:	INC	HL
	BIT	7,(HL)
	JR	Z,LEX1
	JR	LEX0
LEX2:	PUSH	IY		;SAVE POINTER
LEX3:	INC	HL
	BIT	7,(HL)
	JR	NZ,LEX6		;FOUND
	INC	IY
	LD	A,(IY)
	CP	'.'
	JR	Z,LEX6		;FOUND (ABBREV.)
	CP	(HL)
	JR	Z,LEX3
	CALL	RANGE1
	JR	C,LEX5
LEX4:	POP	IY		;RESTORE POINTER
	JR	LEX1
LEX5:	LD	A,(HL)
	OR	A
	JR	NZ,LEX4
	DEC	IY
LEX6:	POP	AF
	XOR	A
	LD	A,B
	RET
;
;DEL - DELETE A PROGRAM LINE.
;   Inputs: HL addresses program line.
; Destroys: B,C,F
;
DEL:	PUSH	DE
	PUSH	HL
	PUSH	HL
	LD	B,0
	LD	C,(HL)
	ADD	HL,BC
	PUSH	HL
	EX	DE,HL
	LD	HL,(TOP)
	SBC	HL,DE
	LD	B,H
	LD	C,L
	POP	HL
	POP	DE
	LDIR			;DELETE LINE
	LD	(TOP),DE
	POP	HL
	POP	DE
	RET
;
;LOAD0 - LOAD A DISK FILE THEN CLEAN.
;   Inputs: Filename in ACC$ (term CR)
; Destroys: A,B,C,D,E,H,L,F
;
;CLEAN - CHECK FOR BAD PROGRAM, FIND END OF TEXT
; AND WRITE FF FF, THEN LOAD (TOP).
; Destroys: A,B,C,H,L,F
;
LOAD0:	LD	DE,(PAGE)
	LD	HL,-256
	ADD	HL,SP
	SBC	HL,DE		;FIND AVAILABLE SPACE
	LD	B,H
	LD	C,L
	LD	HL,ACCS
	CALL	OSLOAD		;LOAD
	CALL	NC,NEWIT
	LD	A,0
	JP	NC,ERROR	;"No room"
CLEAN:	CALL	SETTOP
	DEC	HL
	LD	(HL),-1		;WRITE &FFFF
	DEC	HL
	LD	(HL),-1
	JR	CLEAR
;
SETTOP:	LD	HL,(PAGE)
	LD	B,0
	LD	A,CR
SETOP1:	LD	C,(HL)
	INC	C
	DEC	C
	JR	Z,SETOP2
	ADD	HL,BC
	DEC	HL
	CP	(HL)
	INC	HL
	JR	Z,SETOP1
	JP	BAD
SETOP2:	INC	HL		;N.B. CALLED FROM NEWIT
	INC	HL
	INC	HL
	LD	(TOP),HL
	RET
;
;NEWIT - NEW PROGRAM THEN CLEAR
;   Destroys: H,L
;
;CLEAR - CLEAR ALL DYNAMIC VARIABLES INCLUDING
; FUNCTION AND PROCEDURE POINTERS.
;   Destroys: Nothing
;
NEWIT:	LD	HL,(PAGE)
	LD	(HL),0
	CALL	SETOP2
CLEAR:	PUSH	HL
	LD	HL,(TOP)
	LD	(LOMEM),HL
	LD	(FREE),HL
	LD	HL,DYNVAR
	PUSH	BC
	LD	B,2*(54+2)
CLEAR1:	LD	(HL),0
	INC	HL
	DJNZ	CLEAR1
	POP	BC
	POP	HL
	RET
;
;LISTIT - LIST A PROGRAM LINE.
;    Inputs: HL addresses line
;            DE = line number (binary)
;            IX addresses LISTON
;  Destroys: A,D,E,B',C',D',E',H',L',IY,F
;
LISTIT:	PUSH	HL
	EX	DE,HL
	PUSH	BC
	CALL	PBCD
	POP	BC
	POP	HL
	LD	A,(HL)
	CP	NEXT
	CALL	Z,INDENT
	CP	UNTIL
	CALL	Z,INDENT
	EXX
	LD	A,' '
	BIT	0,(IX)
	CALL	NZ,OUTCHR
	LD	A,B
	ADD	A,A
	BIT	1,(IX)
	CALL	NZ,FILL
	LD	A,C
	ADD	A,A
	BIT	2,(IX)
	CALL	NZ,FILL
	EXX
	LD	A,(HL)
	CP	FOR
	CALL	Z,INDENT
	CP	REPEAT
	CALL	Z,INDENT
	LD	E,0
LIST8:	LD	A,(HL)
	INC	HL
	CP	CR
	JR	Z,CRLF
	CP	'"' ;"
	JR	NZ,LIST7
	INC	E
LIST7:	CALL	LOUT
	JR	LIST8
;
PRLINO:	PUSH	HL
	POP	IY
	PUSH	BC
	CALL	DECODE
	POP	BC
	EXX
	PUSH	BC
	CALL	PBCDL
	POP	BC
	EXX
	PUSH	IY
	POP	HL
	RET
;
LOUT:	BIT	0,E
	JR	NZ,OUTCHR
	CP	LINO
	JR	Z,PRLINO
	CALL	OUT
	LD	A,(HL)
INDENT:	EXX
	CP	FOR
	JR	Z,IND1
	CP	NEXT
	JR	NZ,IND2
	DEC	B
	JP	P,IND2
IND1:	INC	B
IND2:	CP	REPEAT
	JR	Z,IND3
	CP	UNTIL
	JR	NZ,IND4
	DEC	C
	JP	P,IND4
IND3:	INC	C
IND4:	EXX
	RET
;
;CRLF - SEND CARRIAGE RETURN, LINE FEED.
;  Destroys: A,F
;OUTCHR - OUTPUT A CHARACTER TO CONSOLE.
;    Inputs: A = character
;  Destroys: A,F
;
CRLF:	LD	A,CR
	CALL	OUTCHR
	LD	A,LF
OUTCHR:	CALL	OSWRCH
	SUB	CR
	JR	Z,CARRET
	RET	C		;NON-PRINTING
	LD	A,(COUNT)
	INC	A
CARRET:	LD	(COUNT),A
	RET	Z
	PUSH	HL
	LD	HL,(WIDTH)
	CP	L
	POP	HL
	RET	NZ
	JR	CRLF
;
;OUT - SEND CHARACTER OR KEYWORD
;   Inputs: A = character (>=10, <128)
;           A = Token (<10, >=128)
;  Destroys: A,F
;
OUT:	CP	138
	JP	PE,OUTCHR
	PUSH	BC
	PUSH	HL
	LD	HL,KEYWDS
	LD	BC,KEYWDL
	CPIR
TOKEN1:	LD	A,(HL)
	INC	HL
	CP	138
	PUSH	AF
	CALL	PE,OUTCHR
	POP	AF
	JP	PE,TOKEN1
	POP	HL
	POP	BC
	RET
;
;FINDL - FIND PROGRAM LINE.
;   Inputs: HL = line number (binary)
;  Outputs: HL addresses line (if found)
;           DE = line number
;           Z-flag set if found.
; Destroys: A,B,C,D,E,H,L,F
;
FINDL:	EX	DE,HL
	LD	HL,(PAGE)
	XOR	A		;A=0
	CP	(HL)
	INC	A
	RET	NC
	XOR	A		;CLEAR CARRY
	LD	B,A
FINDL1:	LD	C,(HL)
	PUSH	HL
	INC	HL
	LD	A,(HL)
	INC	HL
	LD	H,(HL)
	LD	L,A
	SBC	HL,DE
	POP	HL
	RET	NC		;FOUND OR PAST
	ADD	HL,BC
	JP	FINDL1
;
;SETLIN - Search program for line containing address.
;         Update (LINENO).
;   Inputs: Address in (ERRLIN)
;  Outputs: Line number in HL and (LINENO)
; Destroys: B,C,D,E,H,L,F
;
SETLIN:	LD	B,0
	LD	DE,(ERRLIN)
	LD	HL,(PAGE)
	OR	A
	SBC	HL,DE
	ADD	HL,DE
	JR	NC,SET3
SET1:	LD	C,(HL)
	INC	C
	DEC	C
	JR	Z,SET3
	ADD	HL,BC
	SBC	HL,DE
	ADD	HL,DE
	JR	C,SET1
	SBC	HL,BC
	INC	HL
	LD	E,(HL)		;LINE NUMBER
	INC	HL
	LD	D,(HL)
	EX	DE,HL
SET2:	LD	(LINENO),HL
	RET
SET3:	LD	HL,0
	JR	SET2
;
;SAYLN - PRINT " at line nnnn" MESSAGE.
;  Outputs: Carry=0 if line number is zero.
;           Carry=1 if line number is non-zero.
; Destroys: A,B,C,D,E,H,L,F
;
SAYLN:	LD	HL,(LINENO)
	LD	A,H
	OR	L
	RET	Z
	CALL	TELL
	DEFM	" at line "
	DEFB	0
PBCDL:	LD	C,0
	JR	PBCD0
;
;PBCD - PRINT NUMBER AS DECIMAL INTEGER.
;   Inputs: HL = number (binary).
;  Outputs: Carry = 1
; Destroys: A,B,C,D,E,H,L,F
;
PBCD:	LD	C,' '
PBCD0:	LD	B,5
	LD	DE,10000
PBCD1:	XOR	A
PBCD2:	SBC	HL,DE
	INC	A
	JR	NC,PBCD2
	ADD	HL,DE
	DEC	A
	JR	Z,PBCD3
	SET	4,C
	SET	5,C
PBCD3:	OR	C
	CALL	NZ,OUTCHR
	LD	A,B
	CP	5
	JR	Z,PBCD4
	ADD	HL,HL
	LD	D,H
	LD	E,L
	ADD	HL,HL
	ADD	HL,HL
	ADD	HL,DE
PBCD4:	LD	DE,1000
	DJNZ	PBCD1
	SCF
	RET
;
;PUTVAR - CREATE VARIABLE AND INITIALISE TO ZERO.
;   Inputs: HL, IY as returned from GETVAR (NZ).
;  Outputs: As GETVAR.
; Destroys: everything
;
PUTVAR:	CALL	CREATE
	LD	A,(IY)
	CP	'('
	JR	NZ,GETVZ	;SET EXIT CONDITIONS
ARRAY:	LD	A,14		;'Array'
ERROR3:	JP	ERROR
;
;GETVAR - GET LOCATION OF VARIABLE, RETURN IN HL & IX
;   Inputs: IY addresses first character.
;  Outputs: Carry set and NZ if illegal character.
;           Z-flag set if variable found, then:
;            A = variable type (0,4,5,128 or 129)
;            HL = IX = variable pointer.
;            IY updated
;           If Z-flag & carry reset, then:
;            HL, IY set for subsequent PUTVAR call.
; Destroys: everything
;
GETVAR:	LD	A,(IY)
	CP	'$'
	JR	Z,GETV4
	CP	'!'
	JR	Z,GETV5
	CP	'?'
	JR	Z,GETV6
	CALL	LOCATE
	RET	NZ
	LD	A,(IY)
	CP	'('		;ARRAY?
	JR	NZ,GETVX	;EXIT
	PUSH	DE		;SAVE TYPE
	LD	A,(HL)		;NO. OF DIMENSIONS
	OR	A
	JR	Z,ARRAY
	INC	HL
	LD	DE,0		;ACCUMULATOR
	PUSH	AF
	INC	IY		;SKIP (
	JR	GETV3
GETV2:	PUSH	AF
	CALL	COMMA
GETV3:	PUSH	HL
	PUSH	DE
	CALL	EXPRI		;SUBSCRIPT
	EXX
	POP	DE
	EX	(SP),HL
	LD	C,(HL)
	INC	HL
	LD	B,(HL)
	INC	HL
	EX	(SP),HL
	EX	DE,HL
	PUSH	DE
	CALL	MUL16		;HL=HL*BC
	POP	DE
	ADD	HL,DE
	EX	DE,HL
	OR	A
	SBC	HL,BC
	LD	A,15
	JR	NC,ERROR3	;"Subscript"
	POP	HL
	POP	AF
	DEC	A		;DIMENSION COUNTER
	JR	NZ,GETV2
	CALL	BRAKET		;CLOSING BRACKET
	POP	AF		;RESTORE TYPE
	PUSH	HL
	CALL	X4OR5		;DE=DE*n
	POP	HL
	ADD	HL,DE
	LD	D,A		;TYPE
	LD	A,(IY)
GETVX:	CP	'?'
	JR	Z,GETV9
	CP	'!'
	JR	Z,GETV8
GETVZ:	PUSH	HL		;SET EXIT CONDITIONS
	POP	IX
	LD	A,D
	CP	A
	RET
;
;PROCESS UNARY & BINARY INDIRECTION:
;
GETV4:	LD	A,128		;STATIC STRING
	JR	GETV7
GETV5:	LD	A,4		;UNARY 32-BIT INDIRN.
	JR	GETV7
GETV6:	XOR	A		;UNARY 8-BIT INDIRECTION
GETV7:	LD	HL,0
	PUSH	AF
	JR	GETV0
;
GETV8:	LD	B,4		;32-BIT BINARY INDIRN.
	JR	GETVA
GETV9:	LD	B,0		;8-BIT BINARY INDIRN.
GETVA:	PUSH	HL
	POP	IX
	LD	A,D		;TYPE
	CP	129
	RET	Z		;STRING!
	PUSH	BC
	CALL	LOADN		;LEFT OPERAND
	CALL	SFIX
	EXX
GETV0:	PUSH	HL
	INC	IY
	CALL	ITEMI
	EXX
	POP	DE
	POP	AF
	ADD	HL,DE
	PUSH	HL
	POP	IX
	CP	A
	RET
;
;GETDEF - Find entry for FN or PROC in dynamic area.
;   Inputs: IY addresses byte following "DEF" token.
;  Outputs: Z flag set if found
;           Carry set if neither FN or PROC first.
;           If Z: HL points to entry
;                 IY addresses delimiter
; Destroys: A,D,E,H,L,IY,F
;
GETDEF:	LD	A,(IY+1)
	CALL	RANGE1
	RET	C
	LD	A,(IY)
	LD	HL,FNPTR
	CP	FN
	JR	Z,LOC2
	LD	HL,PROPTR
	CP	PROC
	JR	Z,LOC2
	SCF
	RET
;
;LOCATE - Try to locate variable name in static or
;dynamic variables.  If illegal first character return
;carry, non-zero.  If found, return no-carry, zero.
;If not found, return no-carry, non-zero.
;   Inputs: IY addresses first character of name.
;           A=(IY)
;  Outputs: Z-flag set if found, then:
;            IY addresses terminator
;            HL addresses location of variable
;            D=type of variable:  4 = integer
;                                 5 = floating point
;                               129 = string
; Destroys: A,D,E,H,L,IY,F
;
LOCATE:	SUB	'@'
	RET	C
	LD	H,0
	CP	'Z'-'@'+1
	JR	NC,LOC0		;NOT STATIC
	ADD	A,A
	LD	L,A
	LD	A,(IY+1)	;2nd CHARACTER
	CP	'%'
	JR	NZ,LOC1		;NOT STATIC
	LD	A,(IY+2)
	CP	'('
	JR	Z,LOC1		;NOT STATIC
	ADD	HL,HL
	LD	DE,STAVAR	;STATIC VARIABLES
	ADD	HL,DE
	INC	IY
	INC	IY
	LD	D,4		;INTEGER TYPE
	XOR	A
	RET
;
LOC0:	CP	'_'-'@'
	RET	C
	CP	'z'-'@'+1
	CCF
	DEC	A		;SET NZ
	RET	C
	SUB	3
	ADD	A,A
	LD	L,A
LOC1:	LD	DE,DYNVAR	;DYNAMIC VARIABLES
	DEC	L
	DEC	L
	SCF
	RET	M
	ADD	HL,DE
LOC2:	LD	E,(HL)
	INC	HL
	LD	D,(HL)
	LD	A,D
	OR	E
	JR	Z,LOC6		;UNDEFINED VARIABLE
	LD	H,D
	LD	L,E
	INC	HL		;SKIP LINK
	INC	HL
	PUSH	IY
LOC3:	LD	A,(HL)		;COMPARE
	INC	HL
	INC	IY
	CP	(IY)
	JR	Z,LOC3
	OR	A		;0=TERMINATOR
	JR	Z,LOC5		;FOUND (MAYBE)
LOC4:	POP	IY
	EX	DE,HL
	JP	LOC2		;TRY NEXT ENTRY
;
LOC5:	DEC	IY
	LD	A,(IY)
	CP	'('
	JR	Z,LOC5A		;FOUND
	INC	IY
	CALL	RANGE
	JR	C,LOC5A		;FOUND
	CP	'('
	JR	Z,LOC4		;KEEP LOOKING
	LD	A,(IY-1)
	CALL	RANGE1
	JR	NC,LOC4		;KEEP LOOKING
LOC5A:	POP	DE
TYPE:	LD	A,(IY-1)
	CP	'$'
	LD	D,129
	RET	Z		;STRING
	CP	'%'
	LD	D,4
	RET	Z		;INTEGER
	INC	D
	CP	A
	RET
;
LOC6:	INC	A		;SET NZ
	RET
;
;CREATE - CREATE NEW ENTRY, INITIALISE TO ZERO.
;   Inputs: HL, IY as returned from LOCATE (NZ).
;  Outputs: As LOCATE, GETDEF.
; Destroys: As LOCATE, GETDEF.
;
CREATE:	XOR	A
	LD	DE,(FREE)
	LD	(HL),D
	DEC	HL
	LD	(HL),E
	EX	DE,HL
	LD	(HL),A
	INC	HL
	LD	(HL),A
	INC	HL
LOC7:	INC	IY
	CALL	RANGE		;END OF VARIABLE?
	JR	C,LOC8
	LD	(HL),A
	INC	HL
	CALL	RANGE1
	JR	NC,LOC7
	CP	'('
	JR	Z,LOC8
	LD	A,(IY+1)
	CP	'('
	JR	Z,LOC7
	INC	IY
LOC8:	LD	(HL),0		;TERMINATOR
	INC	HL
	PUSH	HL
	CALL	TYPE
	LD	A,5
	CP	D
	JR	Z,LOC9
	DEC	A
LOC9:	LD	(HL),0		;INITIALISE TO ZERO
	INC	HL
	DEC	A
	JR	NZ,LOC9
	LD	(FREE),HL
	CALL	CHECK
	POP	HL
	XOR	A
	RET
;
;LINNUM - GET LINE NUMBER FROM TEXT STRING
;   Inputs: IY = Text Pointer
;  Outputs: HL = Line number (zero if none)
;           IY updated
; Destroys: A,D,E,H,L,IY,F
;
LINNUM:	CALL	NXT
	LD	HL,0
LINNM1:	LD	A,(IY)
	SUB	'0'
	RET	C
	CP	10
	RET	NC
	INC	IY
	LD	D,H
	LD	E,L
	ADD	HL,HL		;*2
	JR	C,TOOBIG
	ADD	HL,HL		;*4
	JR	C,TOOBIG
	ADD	HL,DE		;*5
	JR	C,TOOBIG
	ADD	HL,HL		;*10
	JR	C,TOOBIG
	LD	E,A
	LD	D,0
	ADD	HL,DE		;ADD IN DIGIT
	JR	NC,LINNM1	
TOOBIG:	LD	A,20
	JP	ERROR		;"Too big"
;
;PAIR - GET PAIR OF LINE NUMBERS FOR RENUMBER/AUTO.
;   Inputs: IY = text pointer
;  Outputs: HL = first number (10 by default)
;           BC = second number (10 by default)
; Destroys: A,B,C,D,E,H,L,B',C',D',E',H',L',IY,F
;
PAIR:	CALL	LINNUM		;FIRST
	LD	A,H
	OR	L
	JR	NZ,PAIR1
	LD	L,10
PAIR1:	CALL	TERMQ
	INC	IY
	PUSH	HL
	LD	HL,10
	CALL	NZ,LINNUM	;SECOND
	EX	(SP),HL
	POP	BC
	LD	A,B
	OR	C
	RET	NZ
	CALL	EXTERR
	DEFM	"Silly"
	DEFB	0
;
;DLPAIR - GET PAIR OF LINE NUMBERS FOR DELETE/LIST.
;   Inputs: IY = text pointer
;  Outputs: HL = points to program text
;           BC = second number (0 by default)
; Destroys: A,B,C,D,E,H,L,IY,F
;
DLPAIR:	CALL	LINNUM
	PUSH	HL
	CALL	TERMQ
	JR	Z,DLP1
	CP	TIF
	JR	Z,DLP1
	INC	IY
	CALL	LINNUM
DLP1:	EX	(SP),HL
	CALL	FINDL
	POP	BC
	RET
;
;TEST FOR VALID CHARACTER IN VARIABLE NAME:
;   Inputs: IY addresses character
;  Outputs: Carry set if out-of-range.
; Destroys: A,F
;
RANGE:	LD	A,(IY)
	CP	'$'
	RET	Z
	CP	'%'
	RET	Z
	CP	'('
	RET	Z
RANGE1:	CP	'0'
	RET	C
	CP	'9'+1
	CCF
	RET	NC
	CP	'@'		;V2.4
	RET	Z
RANGE2:	CP	'A'
	RET	C
	CP	'Z'+1
	CCF
	RET	NC
	CP	'_'
	RET	C
	CP	'z'+1
	CCF
	RET
;
SPACE:	XOR	A
	CALL	EXTERR		;"LINE space"
	DEFB	LINE
	DEFB	8
	DEFB	0
;
;LEXAN - LEXICAL ANALYSIS.
;  Bit 0,C: 1=left, 0=right
;  Bit 3,C: 1=in HEX
;  Bit 4,C: 1=accept line number
;  Bit 5,C: 1=in variable, FN, PROC
;  Bit 6,C: 1=in REM, DATA, *
;  Bit 7,C: 1=in quotes
;   Inputs: IY addresses source string
;           DE addresses destination string
;           (must be page boundary)
;           C  sets initial mode
;  Outputs: DE, IY updated
;           A holds carriage return
;
LEXAN1:	LD	(DE),A		;TRANSFER TO BUFFER
	INC	DE		;INCREMENT POINTERS
	INC	IY
LEXAN2:	LD	A,E		;MAIN ENTRY
	CP	252		;TEST LENGTH
	JR	NC,SPACE	;LINE TOO LONG
	LD	A,(IY)
	CP	CR
	RET	Z		;END OF LINE
	CALL	RANGE1
	JR	NC,LEXAN3
	RES	5,C		;NOT IN VARIABLE
	RES	3,C		;NOT IN HEX
LEXAN3:	CP	' '
	JR	Z,LEXAN1	;PASS SPACES
	CP	','
	JR	Z,LEXAN1	;PASS COMMAS
	CP	'G'
	JR	C,LEXAN4
	RES	3,C		;NOT IN HEX
LEXAN4:	CP	'"' ;"""
	JR	NZ,LEXAN5
	RL	C
	CCF			;TOGGLE C7
	RR	C
LEXAN5:	BIT	4,C
	JR	Z,LEXAN6
	RES	4,C
	PUSH	BC
	PUSH	DE
	CALL	LINNUM		;GET LINE NUMBER
	POP	DE
	POP	BC
	LD	A,H
	OR	L
	CALL	NZ,ENCODE	;ENCODE LINE NUMBER
	JR	LEXAN2		;CONTINUE
;
LEXAN6:	DEC	C
	JR	Z,LEXAN7	;C=1 (LEFT)
	INC	C
	JR	NZ,LEXAN1
	OR	A
	CALL	P,LEX		;TOKENISE IF POSS.
	JR	LEXAN8
;
LEXAN7:	CP	'*'
	JR	Z,LEXAN9
	OR	A
	CALL	P,LEX		;TOKENISE IF POSS.
	CP	TOKLO
	JR	C,LEXAN8
	CP	TOKHI+1
	JR	NC,LEXAN8
	ADD	A,OFFSET	;LEFT VERSION
LEXAN8:	CP	REM
	JR	Z,LEXAN9
	CP	DATA
	JR	NZ,LEXANA
LEXAN9:	SET	6,C		;QUIT TOKENISING
LEXANA:	CP	FN
	JR	Z,LEXANB
	CP	PROC
	JR	Z,LEXANB
	CALL	RANGE2
	JR	C,LEXANC
LEXANB:	SET	5,C		;IN VARIABLE/FN/PROC
LEXANC:	CP	'&'
	JR	NZ,LEXAND
	SET	3,C		;IN HEX
LEXAND:	LD	HL,LIST1
	PUSH	BC
	LD	BC,LIST1L
	CPIR
	POP	BC
	JR	NZ,LEXANE
	SET	4,C		;ACCEPT LINE NUMBER
LEXANE:	LD	HL,LIST2
	PUSH	BC
	LD	BC,LIST2L
	CPIR
	POP	BC
	JR	NZ,LEXANF
	SET	0,C		;ENTER LEFT MODE
LEXANF:	JP	LEXAN1
;
LIST1:	DEFB	GOTO
	DEFB	GOSUB
	DEFB	RESTOR
	DEFB	TRACE
LIST2:	DEFB	THEN
	DEFB	ELSE
LIST1L	EQU	$-LIST1
	DEFB	REPEAT
	DEFB	TERROR
	DEFB	':'
LIST2L	EQU	$-LIST2
;
;ENCODE - ENCODE LINE NUMBER INTO PSEUDO-BINARY FORM.
;   Inputs: HL=line number, DE=string pointer
;  Outputs: DE updated, BIT 4,C set.
; Destroys: A,B,C,D,E,H,L,F
;
ENCODE:	SET	4,C
	EX	DE,HL
	LD	(HL),LINO
	INC	HL
	LD	A,D
	AND	0C0H
	RRCA
	RRCA
	LD	B,A
	LD	A,E
	AND	0C0H
	OR	B
	RRCA
	RRCA
	XOR	01010100B
	LD	(HL),A
	INC	HL
	LD	A,E
	AND	3FH
	OR	'@'
	LD	(HL),A
	INC	HL
	LD	A,D
	AND	3FH
	OR	'@'
	LD	(HL),A
	INC	HL
	EX	DE,HL
	RET
;
;TEXT - OUTPUT MESSAGE.
;   Inputs: HL addresses text (terminated by nul)
;  Outputs: HL addresses character following nul.
; Destroys: A,H,L,F
;
REPORT:	LD	HL,(ERRTXT)
TEXT:	LD	A,(HL)
	INC	HL
	OR	A
	RET	Z
	CALL	OUT
	JR	TEXT
;
;TELL - OUTPUT MESSAGE.
;   Inputs: Text follows subroutine call (term=nul)
; Destroys: A,F
;
TELL:	EX	(SP),HL		;GET RETURN ADDRESS
	CALL	TEXT
	EX	(SP),HL
	RET
;
CR	EQU	0DH
LF	EQU	0AH
ESC	EQU	1BH
