diego123cruz/Z80Mini/BIOS/Programas/Display oled ssd1306_128x32/Main.asm

#include "../Z80MiniAPI.asm"

; Display oled SSD1306 128x32 ou 128x64
oled    .equ    $78

    .org $8000
    
    

inicio:

    ; display on
    LD a, $AF
    CALL send_cmd
    
    ; set display normal
    LD a, $A6
    CALL send_cmd
    
    ; Page mode
    LD a, $02
    CALL send_cmd
    
    ; Charge Pump
    LD a, $8d
    CALL send_cmd
    LD a, $14
    CALL send_cmd
    

    ; 128x32 - Remover para 128x64
    LD a, $a8
    CALL send_cmd
    LD a, $1f
    CALL send_cmd
    
    ; 128x32 - Remover para 128x64
    LD a, $da
    CALL send_cmd
    LD a, $02
    CALL send_cmd

    ; horizontal
    LD a, $20
    CALL send_cmd
    LD a, $00
    CALL send_cmd
    
    ; col
    LD a, $21
    CALL send_cmd
    LD a, 0
    CALL send_cmd
    LD a, 127
    CALL send_cmd
    
    ; row
    LD a, $22
    CALL send_cmd
    LD a, 0
    CALL send_cmd
    LD a, 3
    CALL send_cmd
    
    
    
    call delay_50ms
    
    ;==================

    ; Teste carregamento de imagem por partes de 128x8

    ld b, 128
    ld hl, z1
img:
    ld a, (hl)
    push bc
    push hl
    call send_data
    pop hl
    pop bc
    inc hl
    djnz img


    ld b, 128
    ld hl, z2
img1:
    ld a, (hl)
    push bc
    push hl
    call send_data
    pop hl
    pop bc
    inc hl
    djnz img1
    
    
    ld b, 128
    ld hl, z3
img2:
    ld a, (hl)
    push bc
    push hl
    call send_data
    pop hl
    pop bc
    inc hl
    djnz img2
    
    
    ld b, 128
    ld hl, z4
img3:
    ld a, (hl)
    push bc
    push hl
    call send_data
    pop hl
    pop bc
    inc hl
    djnz img3
    
    

loop:
    CALL keyboardWaitA
    call send_data
    JP loop

    

delay_50ms:
    LD DE, $0032
    CALL delay
    Ret



send_cmd:
    PUSH AF
    LD A, oled
    CALL I2C_Open
    LD A, $00 ; Commands
    CALL I2C_Write
    POP AF
    CALL I2C_Write
    CALL I2C_Close
    ret


send_data:
    PUSH AF
    LD A, oled
    CALL I2C_Open
    LD A, $40 ; Dados
    CALL I2C_Write
    POP AF
    CALL I2C_Write
    CALL I2C_Close
    ret
    
    

z1: .db 0x00, 0x00, 0x00, 0x00, 0x00, 0x00, 0x00, 0x00, 0x00, 0x00, 0x00, 0x00, 0x00, 0x00, 0x00, 0x00
.db 0x00, 0x00, 0x00, 0x00, 0x00, 0x00, 0x00, 0x00, 0x00, 0x00, 0x00, 0x00, 0x00, 0x00, 0x00, 0x00
.db 0x00, 0x00, 0x00, 0x00, 0x00, 0x00, 0x00, 0x00, 0x00, 0x00, 0x00, 0x00, 0x00, 0x00, 0x00, 0x00
.db 0x00, 0x00, 0x00, 0x00, 0x00, 0x00, 0x00, 0x00, 0x00, 0x00, 0x00, 0x00, 0x00, 0x00, 0x00, 0x00
.db 0x00, 0x00, 0x00, 0x00, 0x00, 0x00, 0x00, 0x00, 0x00, 0x00, 0x00, 0x00, 0x00, 0x00, 0x00, 0x00
.db 0x00, 0x00, 0x00, 0x00, 0x00, 0x00, 0x00, 0x00, 0x00, 0x00, 0x00, 0xC0, 0x20, 0x10, 0x10, 0x10
.db 0x20, 0x00, 0x00, 0x00, 0xC0, 0x30, 0xC0, 0x00, 0x00, 0x00, 0xF0, 0x30, 0xC0, 0x00, 0x00, 0x00
.db 0xC0, 0x30, 0xF0, 0x00, 0x00, 0xF0, 0x90, 0x90, 0x90, 0x00, 0x00, 0x00, 0x00, 0x00, 0x00, 0x00

z2: .db 0x00, 0x03, 0x03, 0x03, 0x83, 0xC3, 0xF3, 0x3B, 0x1F, 0x07, 0x00, 0x00, 0x00, 0x3C, 0x7E, 0xE7
.db 0xC3, 0xC3, 0xE7, 0x3E, 0x1E, 0x00, 0x00, 0x00, 0xF0, 0xFC, 0x0E, 0x03, 0x03, 0x03, 0x03, 0x0E
.db 0xFE, 0xF8, 0x00, 0x00, 0x00, 0x00, 0x00, 0x00, 0x00, 0x00, 0xFF, 0xFF, 0x07, 0x3E, 0xF8, 0xC0
.db 0x00, 0x00, 0x00, 0x00, 0xC0, 0xF8, 0x1E, 0x07, 0xFF, 0xFF, 0x00, 0x00, 0x00, 0x00, 0x00, 0xF3
.db 0xF3, 0x00, 0x00, 0x00, 0x00, 0xF0, 0xF0, 0x60, 0x30, 0x30, 0x30, 0x70, 0xE0, 0xC0, 0x00, 0x00
.db 0x00, 0x00, 0xF3, 0xF3, 0x00, 0x00, 0x00, 0x00, 0x00, 0x00, 0x00, 0x03, 0x04, 0x08, 0x09, 0x09
.db 0x07, 0x00, 0x0C, 0x03, 0x02, 0x02, 0x02, 0x03, 0x0C, 0x00, 0x0F, 0x00, 0x00, 0x03, 0x0C, 0x03
.db 0x00, 0x00, 0x0F, 0x00, 0x00, 0x0F, 0x08, 0x08, 0x08, 0x00, 0x00, 0x00, 0x00, 0x00, 0x00, 0x00

z3: .db 0x00, 0x70, 0x7C, 0x6E, 0x67, 0x61, 0x60, 0x60, 0x60, 0x60, 0x60, 0x00, 0x1C, 0x3E, 0x73, 0x61
.db 0x60, 0x60, 0x61, 0x73, 0x3F, 0x1E, 0x00, 0x00, 0x0F, 0x3F, 0x38, 0x60, 0x60, 0x60, 0x60, 0x38
.db 0x1F, 0x07, 0x00, 0x00, 0x00, 0x00, 0x00, 0x00, 0x00, 0x00, 0x7F, 0x7F, 0x00, 0x00, 0x00, 0x07
.db 0x1F, 0x78, 0x78, 0x1F, 0x07, 0x00, 0x00, 0x00, 0x7F, 0x7F, 0x00, 0x00, 0x00, 0x00, 0x00, 0x7F
.db 0x7F, 0x00, 0x00, 0x00, 0x00, 0x7F, 0x7F, 0x00, 0x00, 0x00, 0x00, 0x00, 0x7F, 0x7F, 0x00, 0x00
.db 0x00, 0x00, 0x7F, 0x7F, 0x00, 0x00, 0x00, 0x00, 0x00, 0x00, 0x00, 0xE0, 0x10, 0x08, 0x08, 0x08
.db 0x10, 0x00, 0xE0, 0x10, 0x08, 0x08, 0x08, 0x10, 0xE0, 0x00, 0x00, 0xF8, 0x88, 0x88, 0x88, 0x70
.db 0x00, 0x00, 0xF8, 0x48, 0x48, 0x48, 0x00, 0x00, 0x00, 0x00, 0x00, 0x00, 0x00, 0x00, 0x00, 0x00
.db 0x00, 0x00, 0x00, 0x00, 0x00, 0x00, 0x00, 0x00, 0x00, 0x00, 0x00, 0x00, 0x00, 0x00, 0x00, 0x00

z4: .db 0x00, 0x00, 0x00, 0x00, 0x00, 0x00, 0x00, 0x00, 0x00, 0x00, 0x00, 0x00, 0x00, 0x00, 0x00, 0x00
.db 0x00, 0x00, 0x00, 0x00, 0x00, 0x00, 0x00, 0x00, 0x00, 0x00, 0x00, 0x00, 0x00, 0x00, 0x00, 0x00
.db 0x00, 0x00, 0x00, 0x00, 0x00, 0x00, 0x00, 0x00, 0x00, 0x00, 0x00, 0x00, 0x00, 0x00, 0x00, 0x00
.db 0x00, 0x00, 0x00, 0x00, 0x00, 0x00, 0x00, 0x00, 0x00, 0x00, 0x00, 0x00, 0x00, 0x00, 0x00, 0x00
.db 0x00, 0x00, 0x00, 0x00, 0x00, 0x00, 0x00, 0x00, 0x00, 0x00, 0x00, 0x00, 0x00, 0x00, 0x00, 0x00
.db 0x00, 0x00, 0x00, 0x00, 0x00, 0x00, 0x00, 0x00, 0x00, 0x00, 0x00, 0x01, 0x02, 0x04, 0x04, 0x04
.db 0x02, 0x00, 0x01, 0x02, 0x04, 0x04, 0x04, 0x02, 0x01, 0x00, 0x00, 0x07, 0x00, 0x00, 0x01, 0x06
.db 0x00, 0x00, 0x07, 0x04, 0x04, 0x04, 0x00, 0x00, 0x00, 0x00, 0x00, 0x00, 0x00, 0x00, 0x00, 0x00








    
