diego123cruz/Z80Mini/BIOS/sdcc /Z80Mini.c

/* =========================================================
   z80mini.c
   ========================================================= */

#include "Z80Mini.h"

/* =========================================================
   DELAY
   ========================================================= */

void delay500ms(void) __naked
{
__asm
    call 0x0100
    ret
__endasm;
}

void delay(uint16_t ms) __naked __sdcccall(1)
{
    ms;

__asm

    ex de,hl
    call 0x0103

    ret
__endasm;
}

/* =========================================================
   I2C
   ========================================================= */

void I2C_Open(uint8_t addr) __naked __sdcccall(1)
{
    addr;

__asm
    call 0x0106
    ret
__endasm;
}

void I2C_Close(void) __naked
{
__asm
    call 0x0109
    ret
__endasm;
}

uint8_t I2C_Read(void) __naked
{
__asm
    call 0x010C
    ret
__endasm;
}

void I2C_Write(uint8_t data) __naked __sdcccall(1)
{
    data;

__asm
    call 0x010F
    ret
__endasm;
}

/* =========================================================
   KEYBOARD
   ========================================================= */

uint8_t keyboardIsEsc(void) __naked
{
__asm
    call 0x0112
    ret
__endasm;
}

uint8_t keyboardWaitA(void) __naked
{
__asm
    call 0x0115
    ret
__endasm;
}

uint8_t keyboardA(void) __naked
{
__asm
    call 0x0118
    ret
__endasm;
}

/* =========================================================
   SERIAL
   ========================================================= */

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

void setBufClear(void) __naked
{
__asm
    call 0x016C
    ret
__endasm;
}

void setBufNoClear(void) __naked
{
__asm
    call 0x016F
    ret
__endasm;
}

/* =========================================================
   GRAFICOS
   ========================================================= */

void drawGraphic(
    uint8_t chr,
    void *data,
    uint8_t w,
    uint8_t h
) __naked __sdcccall(1)
{
    chr;
    data;
    w;
    h;

__asm

    ; A = chr
    ; HL = data
    ; DE = w/h

    call 0x0178
    ret

__endasm;
}

void invGraphic(void) __naked
{
__asm
    call 0x017B
    ret
__endasm;
}

/* =========================================================
   TERMINAL GLCD
   ========================================================= */

void initTerminal(void) __naked
{
__asm
    call 0x017E
    ret
__endasm;
}

void sendCharToLCD(uint8_t c)
__naked __sdcccall(1)
{
    c;

__asm
    call 0x0181
    ret
__endasm;
}

void sendStringToLCD(
    char *txt
) __naked __sdcccall(1)
{
    txt;

__asm
    ex de, hl
    ld a, #0

    call 0x0184
    ret

__endasm;
}

void sendRegToLCD(uint8_t v)
__naked __sdcccall(1)
{
    v;

__asm
    call 0x0187
    ret
__endasm;
}

void sendHLToLCD(uint16_t v)
__naked __sdcccall(1)
{
    v;

__asm
    call 0x018A
    ret
__endasm;
}

void setCursor(
    uint8_t x,
    uint8_t y
) __naked __sdcccall(1)
{
    x;
    y;

__asm
    ld b, a
    ld c, l

    call 0x018D
    ret

__endasm;
}

uint16_t getCursor(void) __naked
{
__asm

    call 0x0190

    ld d, b
    ld e, c

    ret

__endasm;
}

void displayCursor(uint8_t v)
__naked __sdcccall(1)
{
    v;

__asm
    call 0x0193
    ret
__endasm;
}

void autoLF(uint8_t v)
__naked __sdcccall(1)
{
    v;

__asm
    call 0x0196
    ret
__endasm;
}

void underline(void) __naked
{
__asm
    call 0x0199
    ret
__endasm;
}

void plotAlways(uint8_t v)
__naked __sdcccall(1)
{
    v;

__asm
    call 0x019C
    ret
__endasm;
}
