diego123cruz/Z80Mini/(commit log)

2022-01-25 add função para ir para o modo monitor quando esta em modo user, add fake_display para o modo user
2022-02-03 sensor ir test, add halt
2022-02-08 add circuito (pdf + proteus 8.6), add fotos
    [Z80Mini.pdsprj]
2022-02-08 ajuste mapa de utilitarios
2022-08-05 halt sem nmi, novo endereço de programas $1000(ROM), ajuste readme
2022-09-04 add new Z80Mini Face Tec-1 - SouthernCross
    [Link.stl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]
2022-09-05 front - Tec-1F
    [Z80Mini.pdsprj]
2022-09-06 Z80Mini - Add Front Tec-1F
    [Z80Mini.pdsprj]
2022-09-06 add circuito pasta Tec-1F
2022-09-12 add shift test
    [Z80Mini.pdsprj]
2022-11-22 add Basic LCD - Face
    [Link.stl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]
2023-06-24 I2C Shield
    [Z80Mini.pdsprj]
2023-06-25 fix Y final da tela, + ENTER
    [bootV2.asm]
2023-06-25 fix char " and /
    [bootV2.asm]
2023-06-27 Monitor - Add i2c scan
2023-06-27 Monitor - add G AAAA(go to), M AAAA(Modify AAAA), add ESC(SHIFT+C)
2023-06-29 add example i2c
2023-07-01 inicio API, melhoria no print lcd
2023-07-06 add commands: output, input, i2c(read, read_reg, write, write_reg)
2023-07-09 update circuit - add 128x64 graphic
    [Z80Mini.pdsprj]
2023-07-09 add leds
2023-07-10 fix print
2023-09-03 print 8x8
2024-05-25 cload and csave - eeprom i2c, new token TIME - time i2c
2025-03-27 add led capslock on keyboard
2025-04-15 fix read key - update flags
    [Keyboard.asm]
2025-05-06 ajuste esquema eletrico
    [Z80Mini.pdsprj]
2025-05-24 add I2C load from card, example oled ssd1306 - i2c
2025-06-14 new external feature - Display 7 segs + som + led
2026-05-25 BIOS - Z80Mini Monitor v1
    [Z80Mini.pdsprj]
2026-08-04 new command i2c
2026-08-27 fix rmdir, add atalho jump (g), call (c), add led capslock na mesma linha de leitura do teclado
    [COMANDOS.asm, FS.asm, Main.asm, TECLADO.asm]
2026-09-08 fix scroll screen - basic, ajust capslock, add zasm files
    [GLCD.asm, MSBASIC.asm, Main.asm, TECLADO.asm]
